sam-mendis/4YP/README.md

# 4YP
My fourth year project repository, looking at designing a lifetime testing container for a 30mm*30mm organic solar cell sample.
Needs to fit inside a glovebox of 150mm diameter
