sam-mendis/4YP/Report/Michaelmas report/Michaelmas report plan.docx

Michaelmas report plan:

1. Introduction:
  a. Define project and aims
  b. Discuss why the project is needed
  c. Review literature to enhance argument for the project
2. What I have done so far:
  a. Talk about research
  b. Learning and creating models on openscad: show 3d model of design
  c. Discuss the research on materials
  d. Discuss the processes what methods of manufacturing
3. Where I will go next:
  a. Initial next steps – coming weeks
  b. Overall next steps, how I am going to accomplish the aims listed
  c. Gant chart showing my progress
4. Conclusion
  a. Show that project is integral
  b. Reiterate how it is on track.

Process generally completed dimensions entire
