sam-mendis/4YP/Report/Samuel Mendis Interim Report.pdf

## Open Science Hardware Setup for investigating the Stability of Organic

## Solar Cells - Interim Report

Samuel Mendis

Department of Engineering Science, University of Oxford

Department of Physics, University of Oxford

23rd November 2020

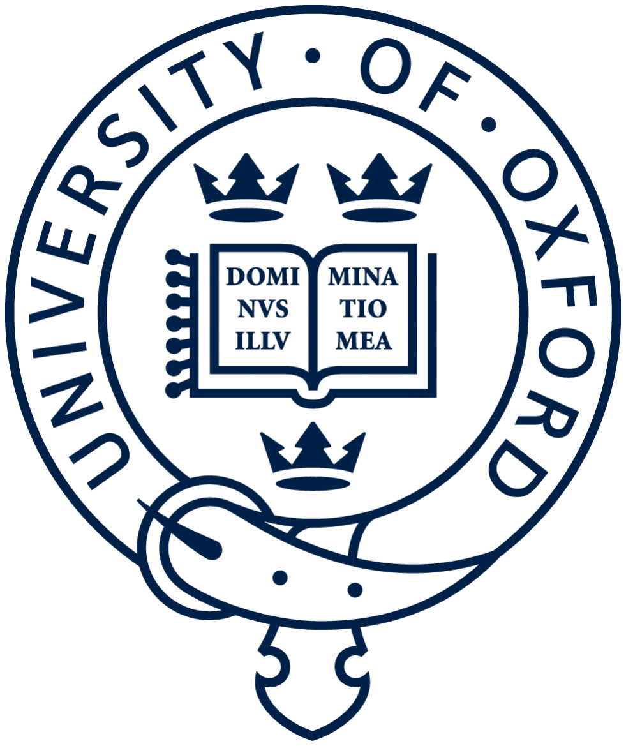
[picture p4: figure]

## 1 Introduction

Solar cells are becoming increasingly prevalent in the fight against climate change[1, p. 34], leading demand

to increase worldwide. This project aims to contribute to the development of the next generation of solar

cells to be manufactured out of carbon-based materials (rather than the current industry standard of

silicon). Currently, controlled lifetime testing of organic solar cells is difficult due to the multitude of

failure mechanisms. These are caused by chemical degradation via oxygen and water[2, p. 689]. To

combat this problem, this project will design, manufacture and test a well controlled lifetime solar testing

container. This project is being run in conjunction with the Advanced Functional Materials and Devices

group (AFMD) in the department of Physics, headed by Professor Moritz Riede. Therefore I am, and

will be collaborating closely with the members of AFMD to ensure the device meets the specification they

require. A key tenet of the project is ensuring the accessibility of the research through the use of open

hardware in order for the potential acceleration of the development of organic solar cells.

## 2 Aims and Objectives

The aim of the container is to simulate a lifetime (for example: 20 years) of real world degradation in a

reasonable timeframe. Reasonable means that ideally the testing container should be able to test the solar

cell in a short cycle test (15 minutes) or a long multiple cycle test (up to 3 months). To ensure accurate

testing of the cells, the container needs to be airtight. This is to prevent any uncontrolled variables from

entering the testing container and causing degradation of the cell. Furthermore, the container should have

gas inlets and outlets so that the conditions that the solar cell is tested under can be varied in a controlled

manner. This will be in conjunction with a temperature controller capable of varying the temperature

of the solar cell up to 120°C. These objectives were guided by the paper Consensus stability testing

protocols for organic photovoltaic materials and devices [3, p. 1255-1261] which cites multiple different

testing criteria for an organic solar cell - in the absence of a tailored ISO standard. Additional aims

that would enhance the scope of the project is a graphical user interface (GUI) developed to control the

conditions within the testing container. To ensure the project is completed, not all the components will

be manufactured from scratch, some will be purchased while others are provided by the AFMD research

group and existing open science hardware/software efforts. Some of the components include: the push-fit

valves, a safety relief valve, o-rings, a mass flow controller and an illumination source.

## 3 Progress

At this stage in the year, the container is past the design stage and is onto manufacturing, with the

outer shell being manufactured within the Engineering Science Workshop. A full design was completed

using the open source software OpenSCAD. Using inspiration from Karl-Augustin Zaininger (a Physics

researcher who has developed a similar type of device, without the functionality) a CAD model of the

testing container was built and is shown in Figure 1.The outer shell (coloured in green) is the component

currently bring manufactured. The red circular parts will be 3D printed using acrylic and will be used to

hold metal pins to connect a controller on the outside to the instrumentation within. The three important

factors that the container had to accommodate were: the substrate (shown in black in Figure 1), any

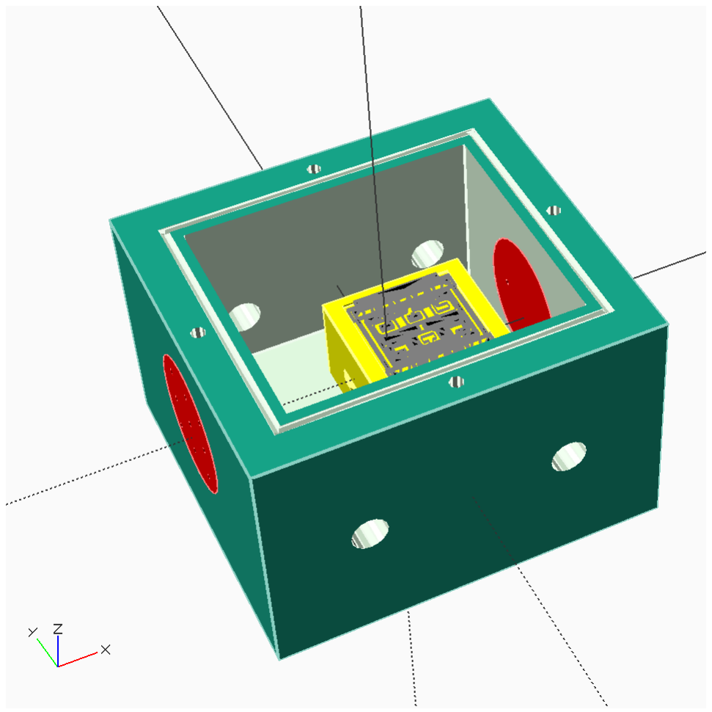
[picture p5: figure]

(a) Plan View of Model | (b) Isometric View of Model

Figure 1: Showing plan and isometric view of the full OpenSCAD model

electronic devices (e.g. a temperature controller) and gas inlet ports. The substrate used carries 6 solar

cells with dimensions of 30 mm x 30 mm and a thickness of 1.1 mm. The substrate design in Figure 1

was provided to me by Dr Grey Christophoro - Physics researcher [4]. In order to carry the substrate in

the testing container, a substrate holder (coloured yellow in Figure 1) was designed to fit within the outer

shell of the box. The modular design is deliberate to allow the user to modify which cells and layouts are

being tested, without the redesign of the entire container, just the substrate holder; thereby saving those

who may need to use it in the future valuable time and money.

## 4 Future Work

During the manufacturing of the box, there is an opportunity to start on simulations of the heat and

mass flow within the container. These simulations will be conducted using SOLIDWORKS flow and

heat simulations features to provide a more accurate picture of the environmental variation around the

substrate. These simulations will allow the user to control the environment with a better understanding,

hence creating more consistent ageing conditions. Once the outer shell has been manufactured, following

key steps are to pressure test the vessel, implement the control electronics, calibrate the temperature

and environmental sensors as well as installing the container in front of a lamp. Once the calibration is

complete the container will be assessed in known control environments to check whether the solar cells

output as predicted. The Gantt chart (shown in the Appendix) shows the full outline of the future plans

including contingency time at the end of Hilary term.

## References

[1] International Energy Agency. World Energy Outlook 2020. OECD Publishing, 2020. URL https: //www.oecd-ilibrary.org/content/publication/557a761b-en.
[2] Mikkel Jørgensen, Kion Norrman, and Frederik C Krebs. Stability/degradation of polymer solar cells. Solar energy materials and solar cells, 92(7):686–714, 2008. ISSN 0927-0248.
[3] Matthew O Reese, Suren A Gevorgyan, Mikkel Jørgensen, Eva Bundgaard, Sarah R Kurtz, David S Ginley, Dana C Olson, Matthew T Lloyd, Pasquale Morvillo, and Eugene A Katz. Consensus stability testing protocols for organic photovoltaic materials and devices. Solar Energy Materials and Solar Cells, 95(5):1253–1267, 2011. ISSN 0927-0248.
[4] AFMD Layout Github Repository, Accessed 30/09/2020. URL https://github.com/AFMD/layouts.

# Appendices

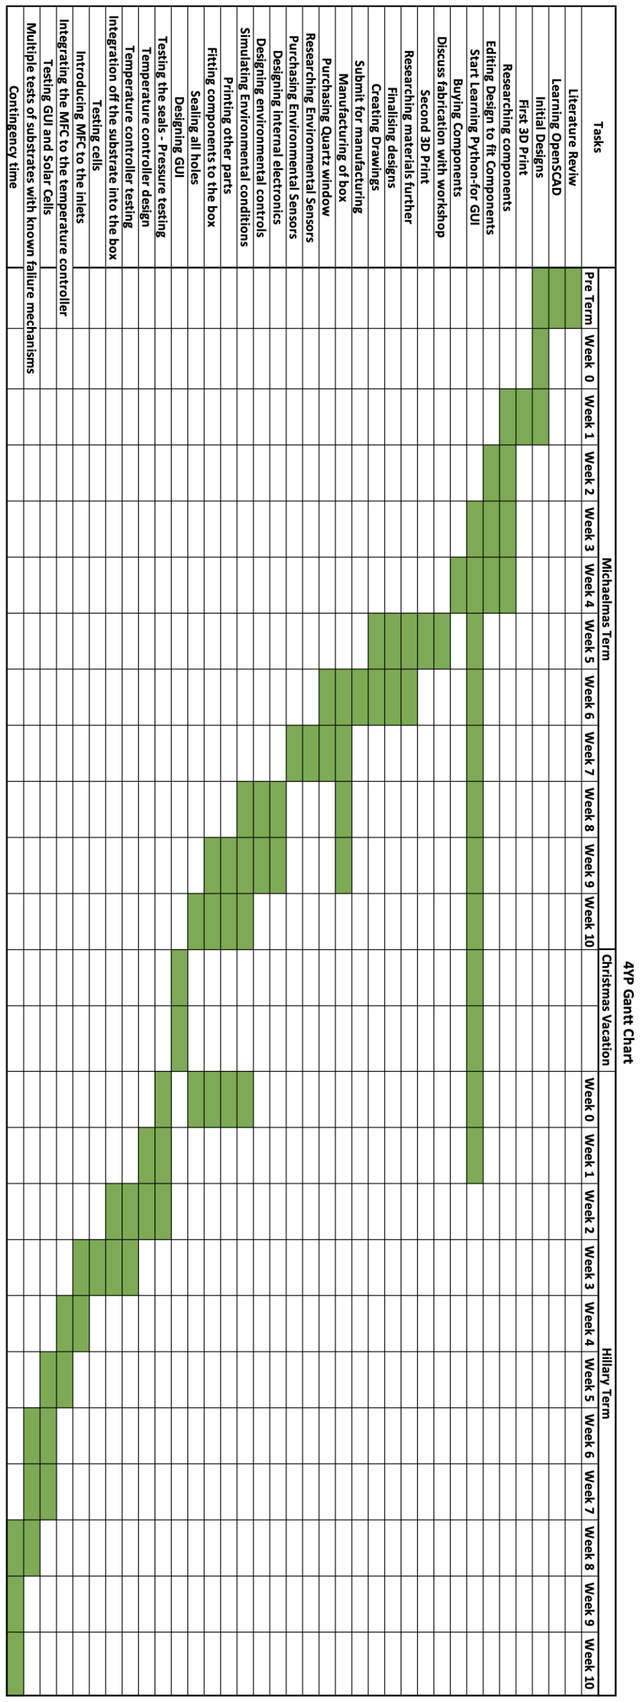
[picture p6: figure]
