sam-mendis/4YP/Report/First attempt /Images/Appendix/Appendix_1.png

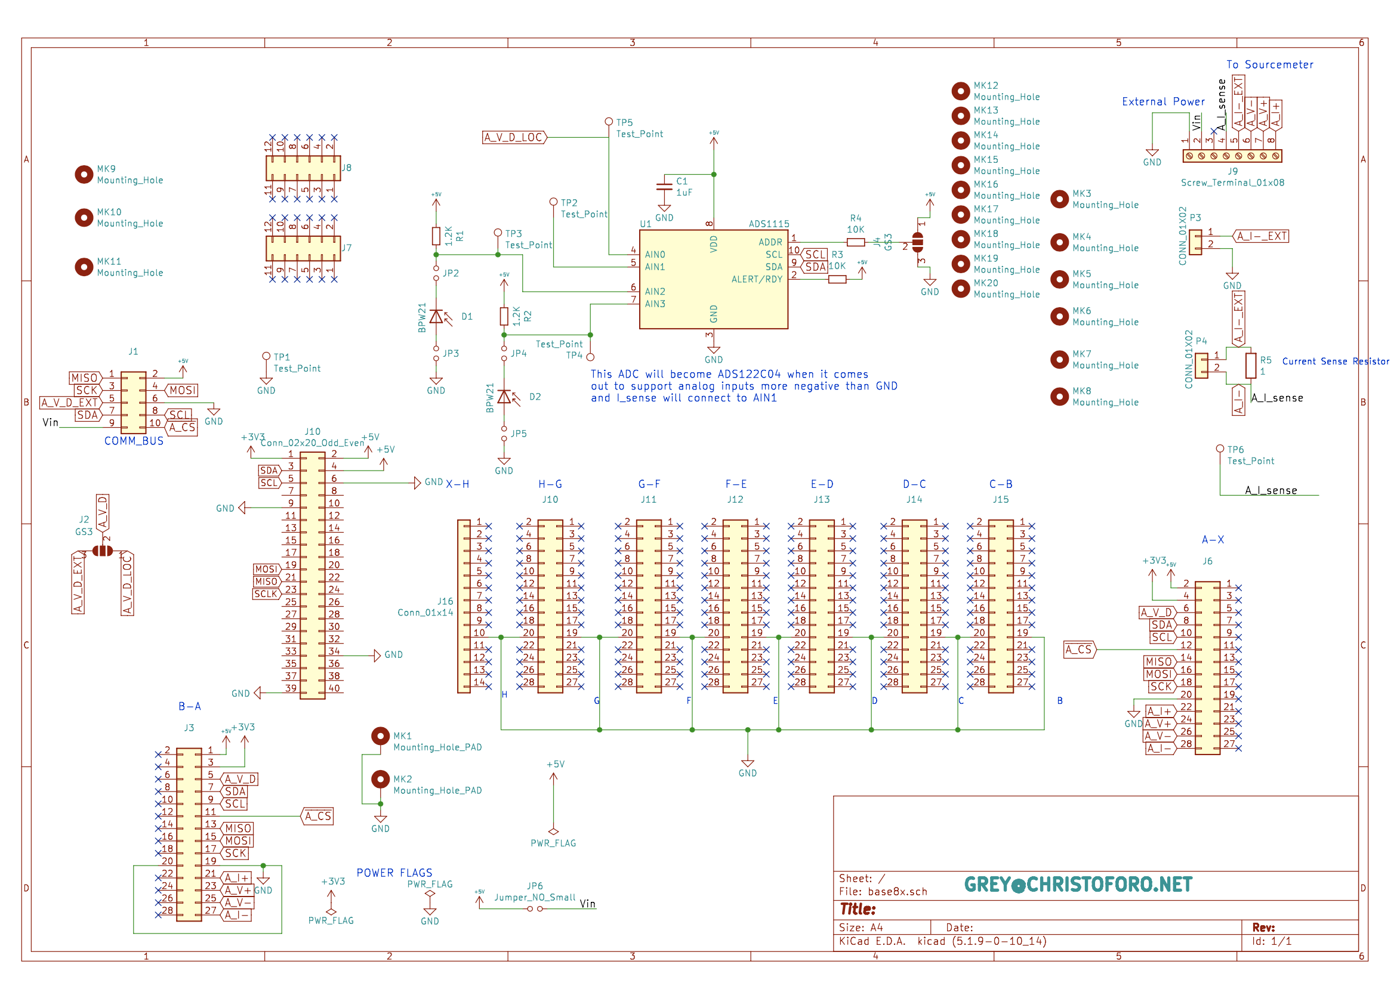
Report/First attempt /Images/Appendix/Appendix_1.png
