sam-mendis/4YP/Report/First attempt /Images/Appendix/Appendix_2.png

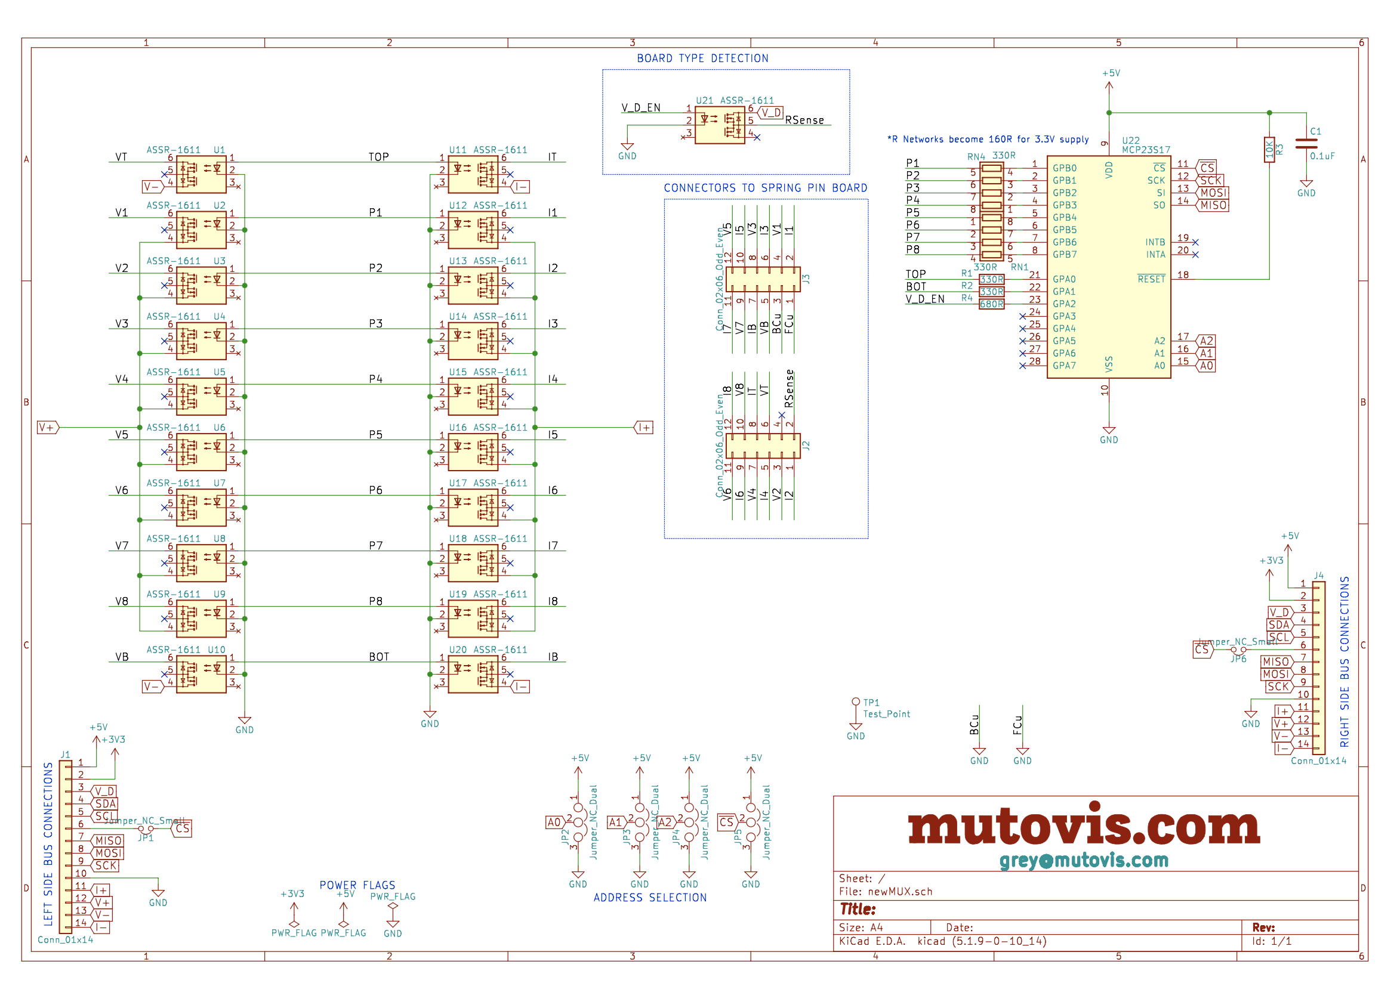
Report/First attempt /Images/Appendix/Appendix_2.png
