sam-mendis/4YP/Report/First attempt /Images/Appendix/Appendix_3.png

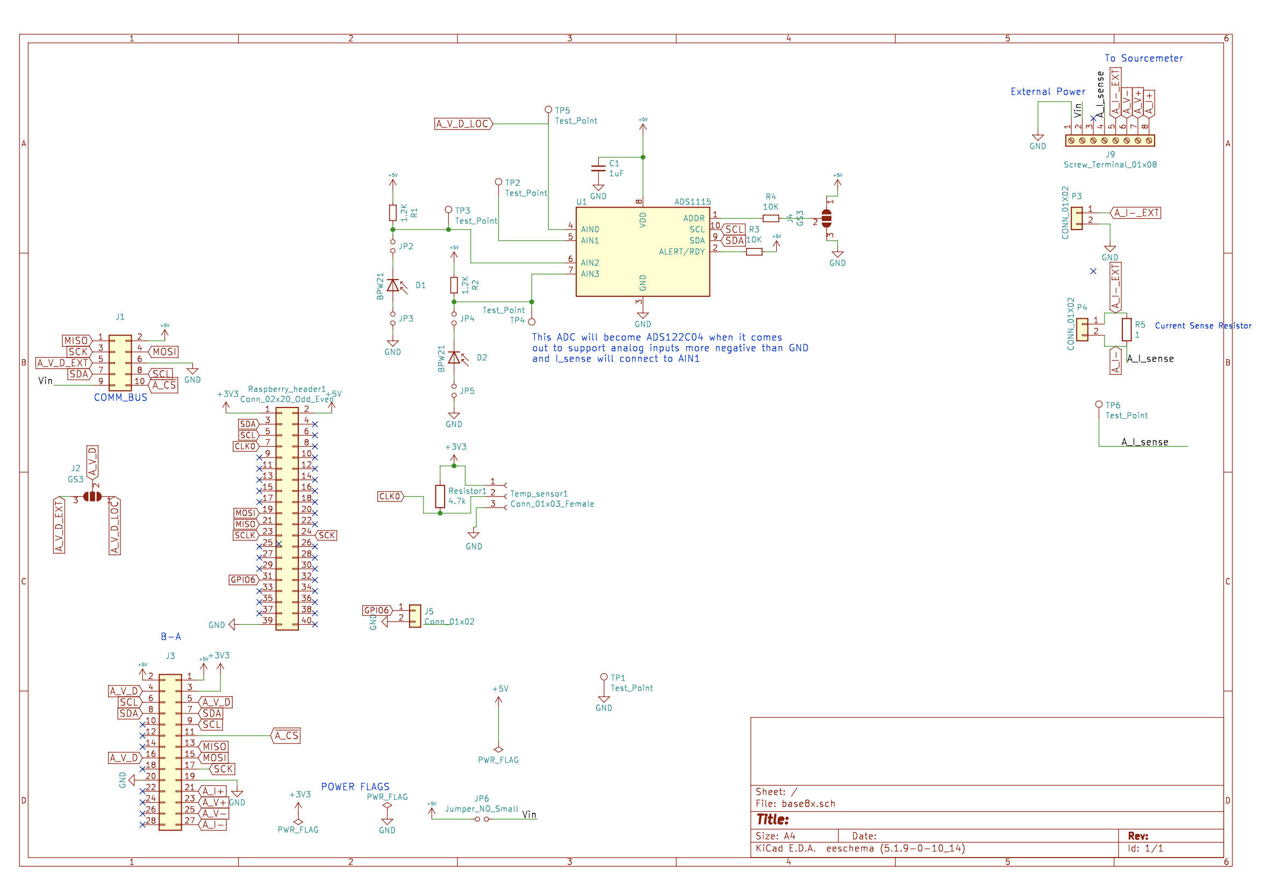
Report/First attempt /Images/Appendix/Appendix_3.png
