sam-mendis/4YP/Report/First attempt /Images/Appendix/Appendix_4.png

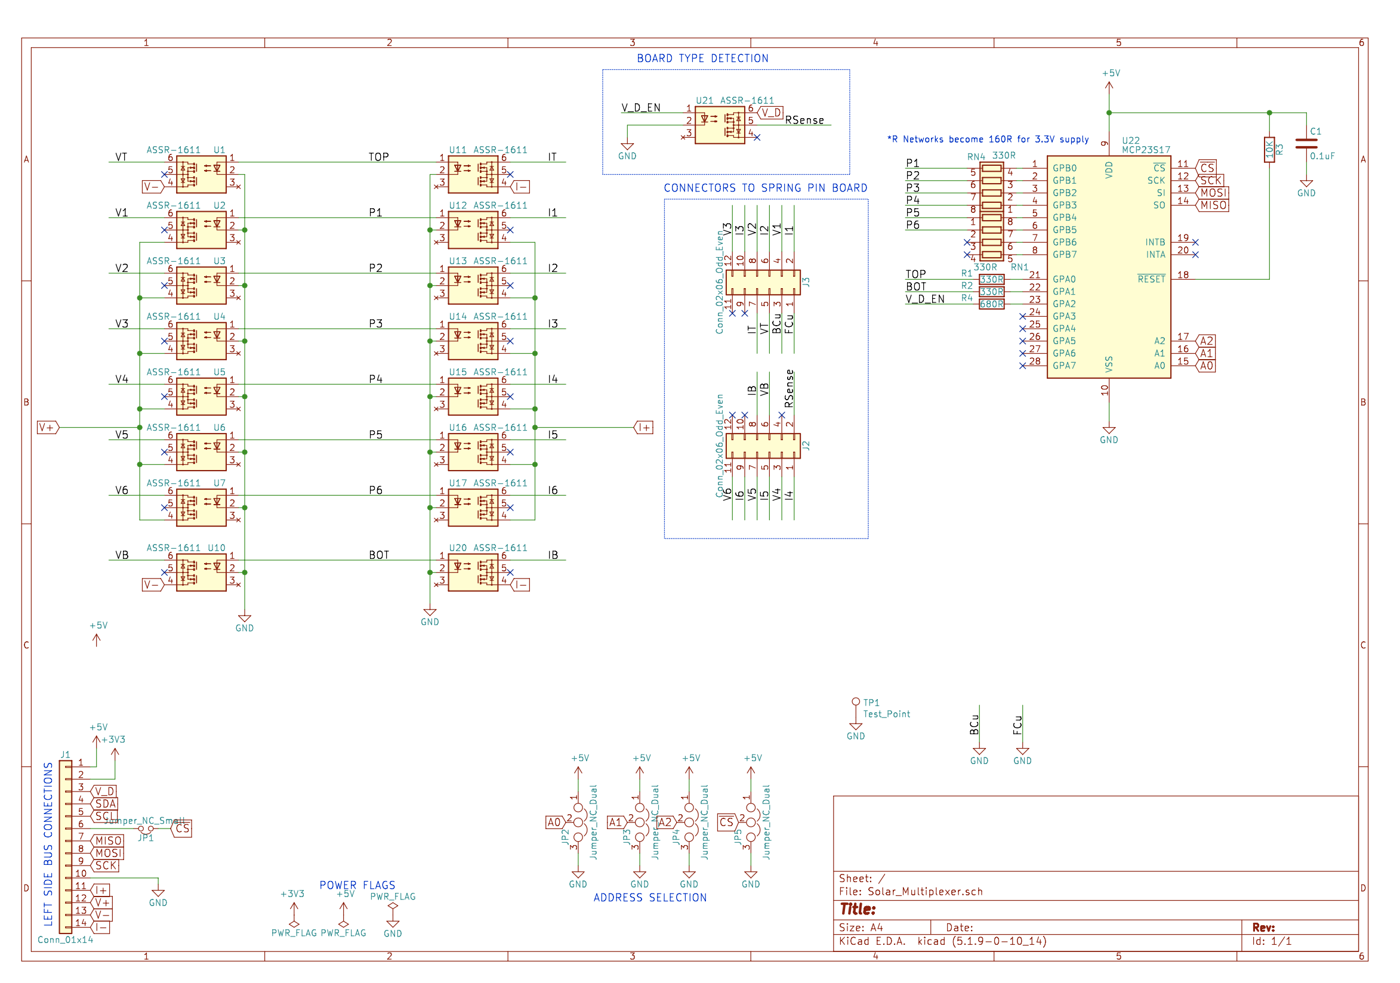
Report/First attempt /Images/Appendix/Appendix_4.png
