sam-mendis/4YP/Report/First attempt /Images/Appendix/Appendix_5.png

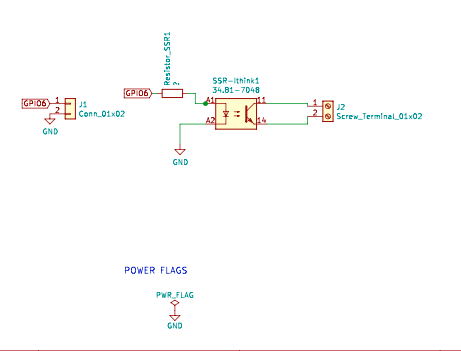
Report/First attempt /Images/Appendix/Appendix_5.png
