sam-mendis/4YP/Report/First attempt /Images/Appendix/Appendix_6.png

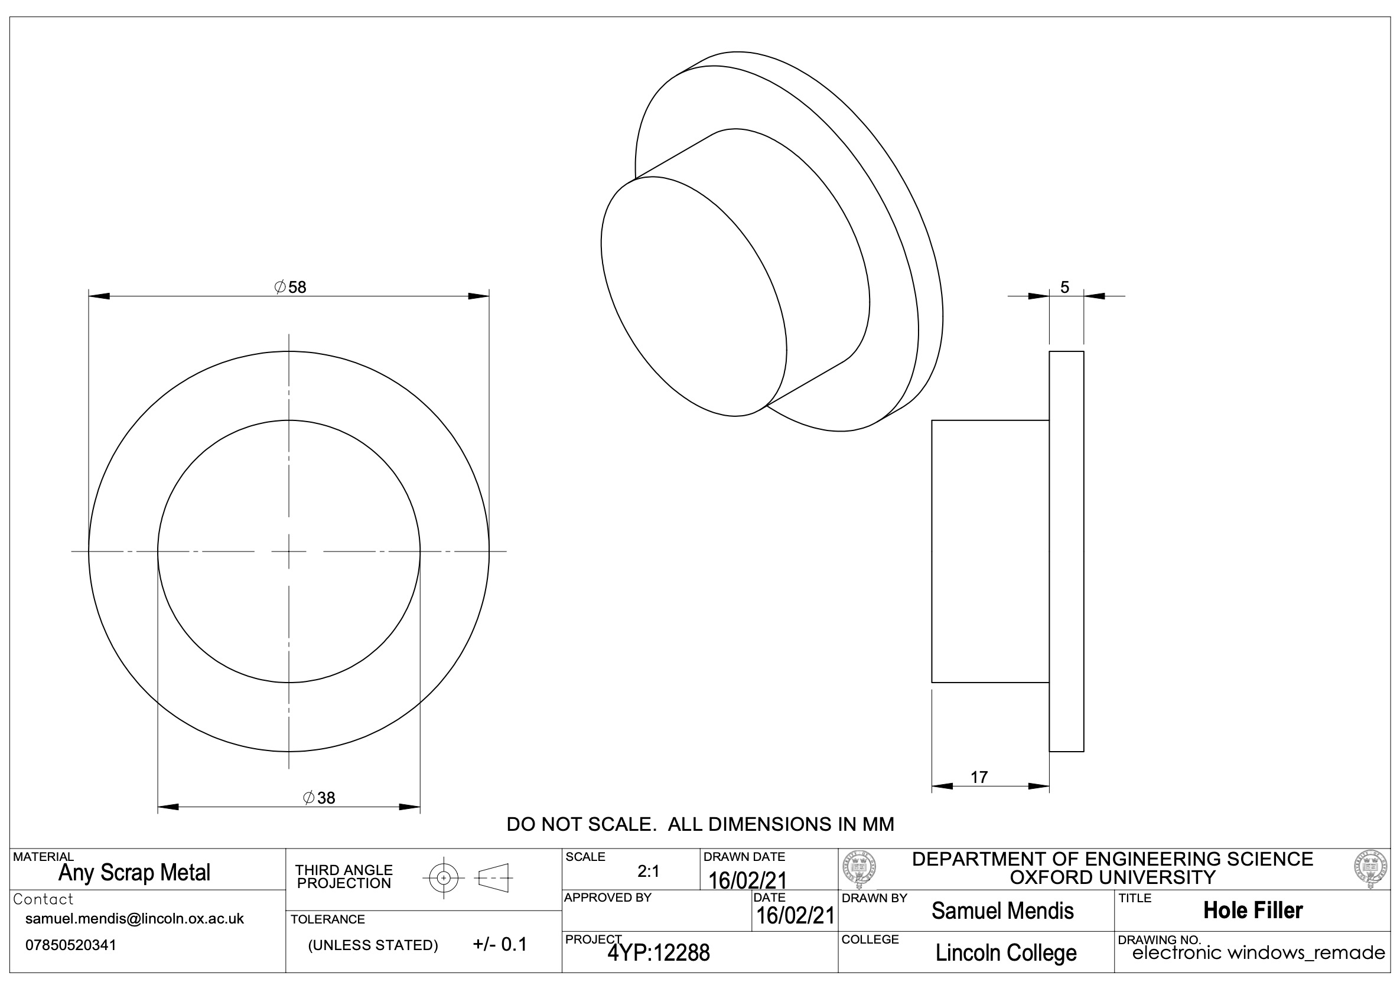
Report/First attempt /Images/Appendix/Appendix_6.png
