sam-mendis/4YP/Report/First attempt /Images/Appendix/Drawing1.png

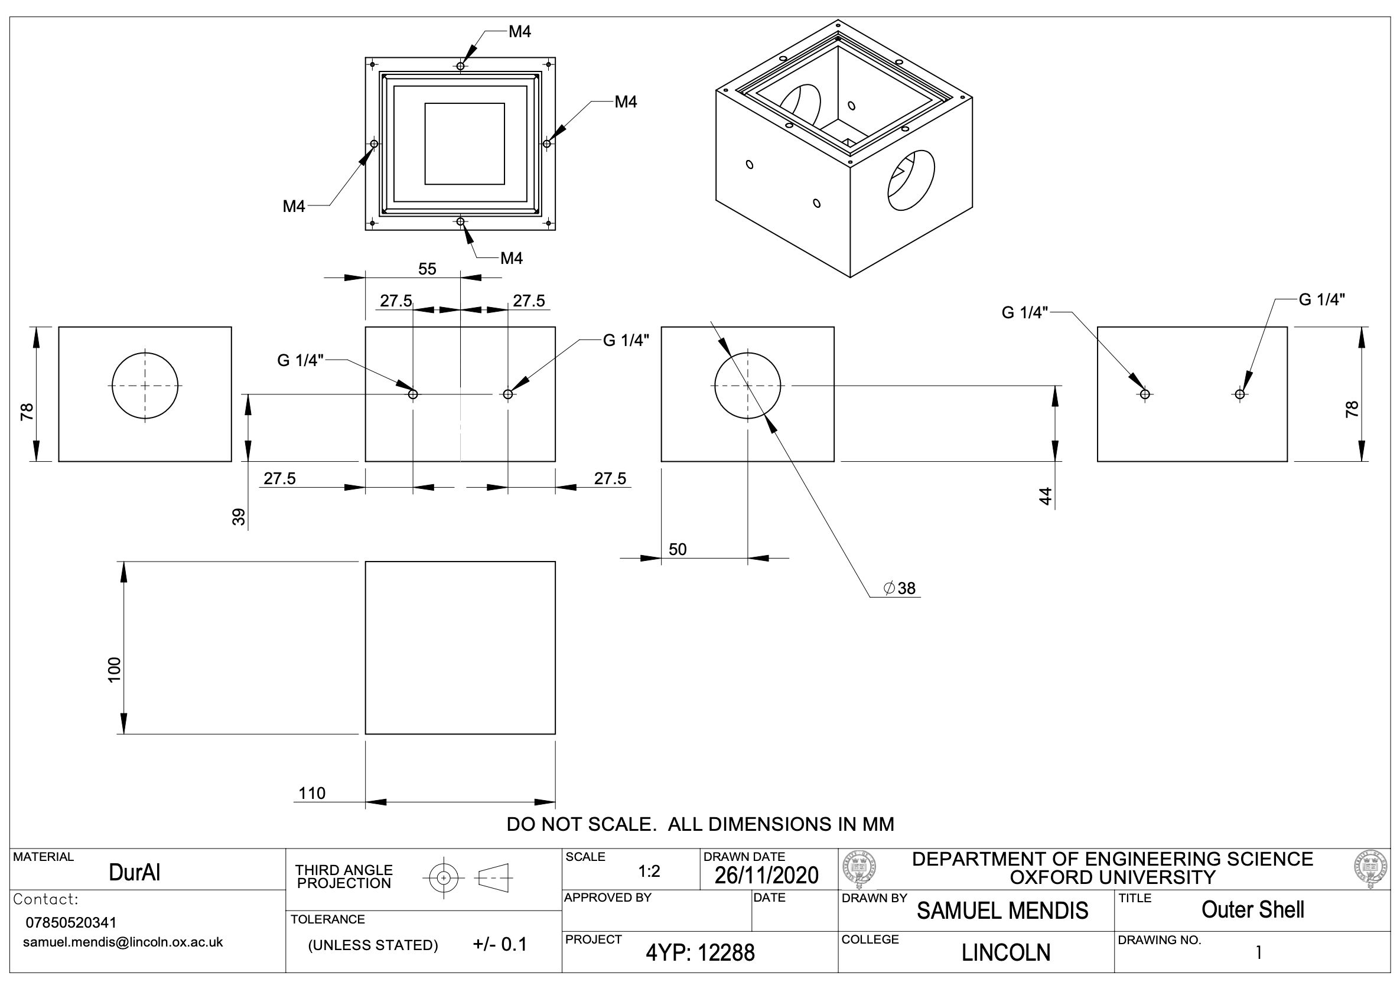
Report/First attempt /Images/Appendix/Drawing1.png
