sam-mendis/4YP/Report/First attempt /Images/Appendix/Drawing2.png

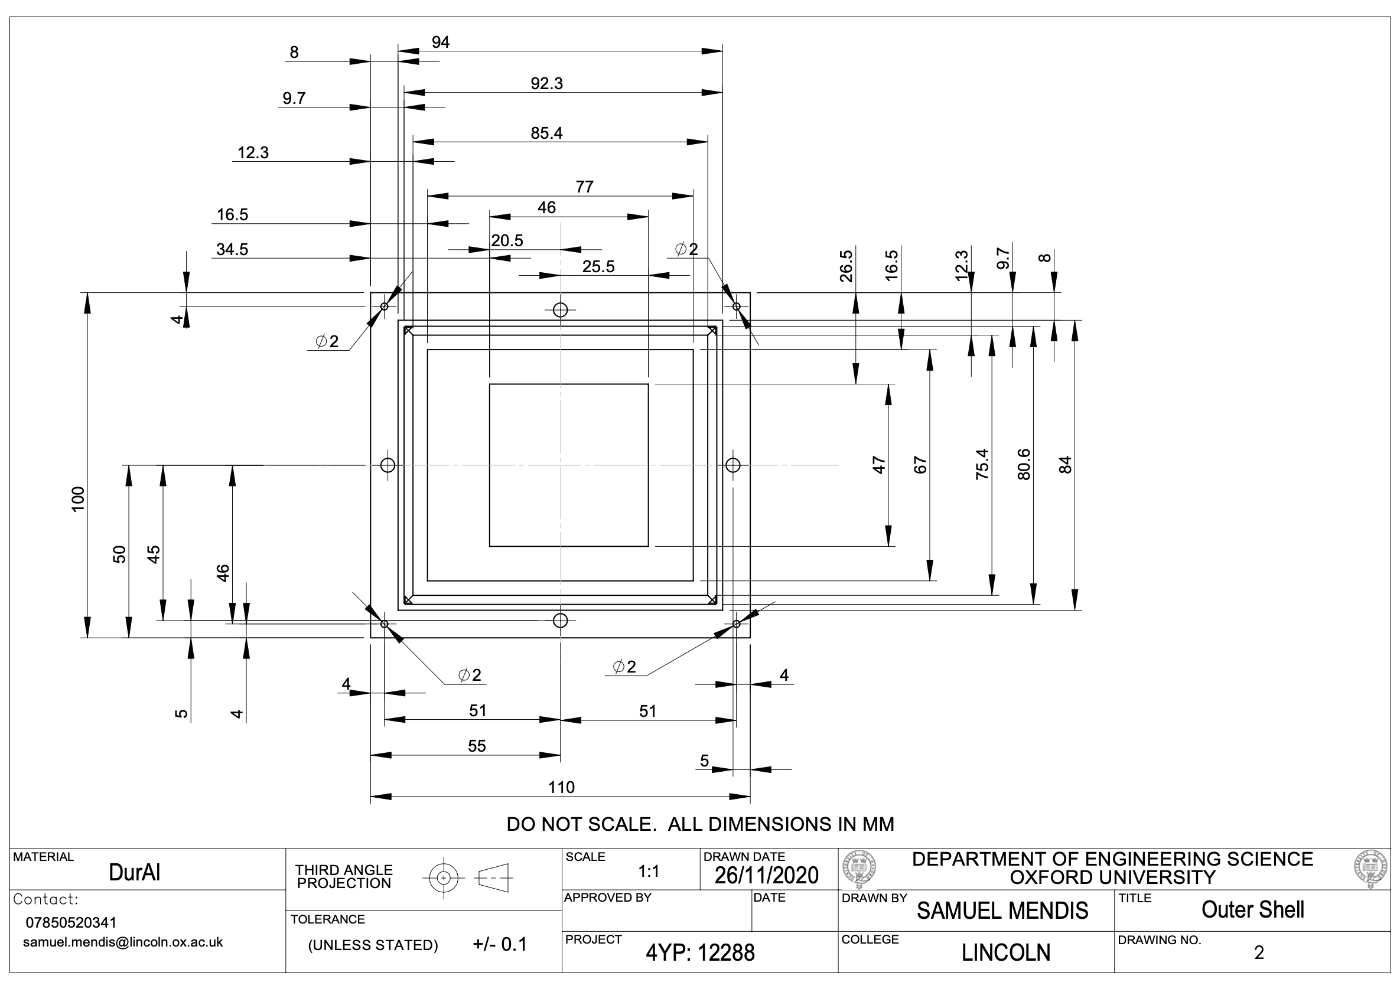
Report/First attempt /Images/Appendix/Drawing2.png
