sam-mendis/4YP/Report/First attempt /Images/Appendix/Drawing3.png

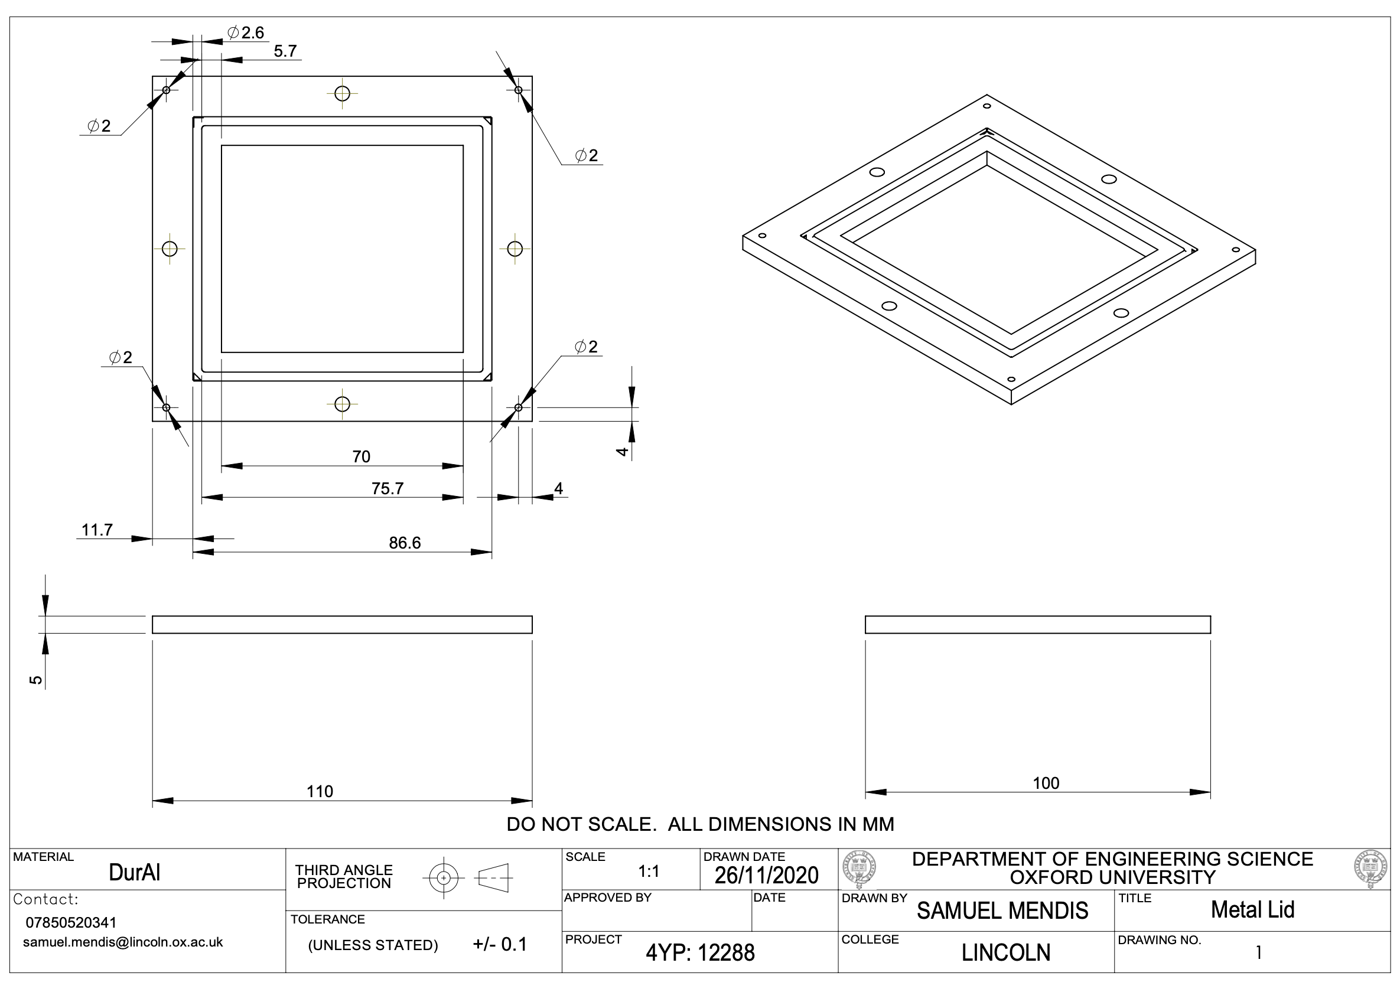
Report/First attempt /Images/Appendix/Drawing3.png
