sam-mendis/4YP/Report/First attempt /Images/Appendix/Gantt.png

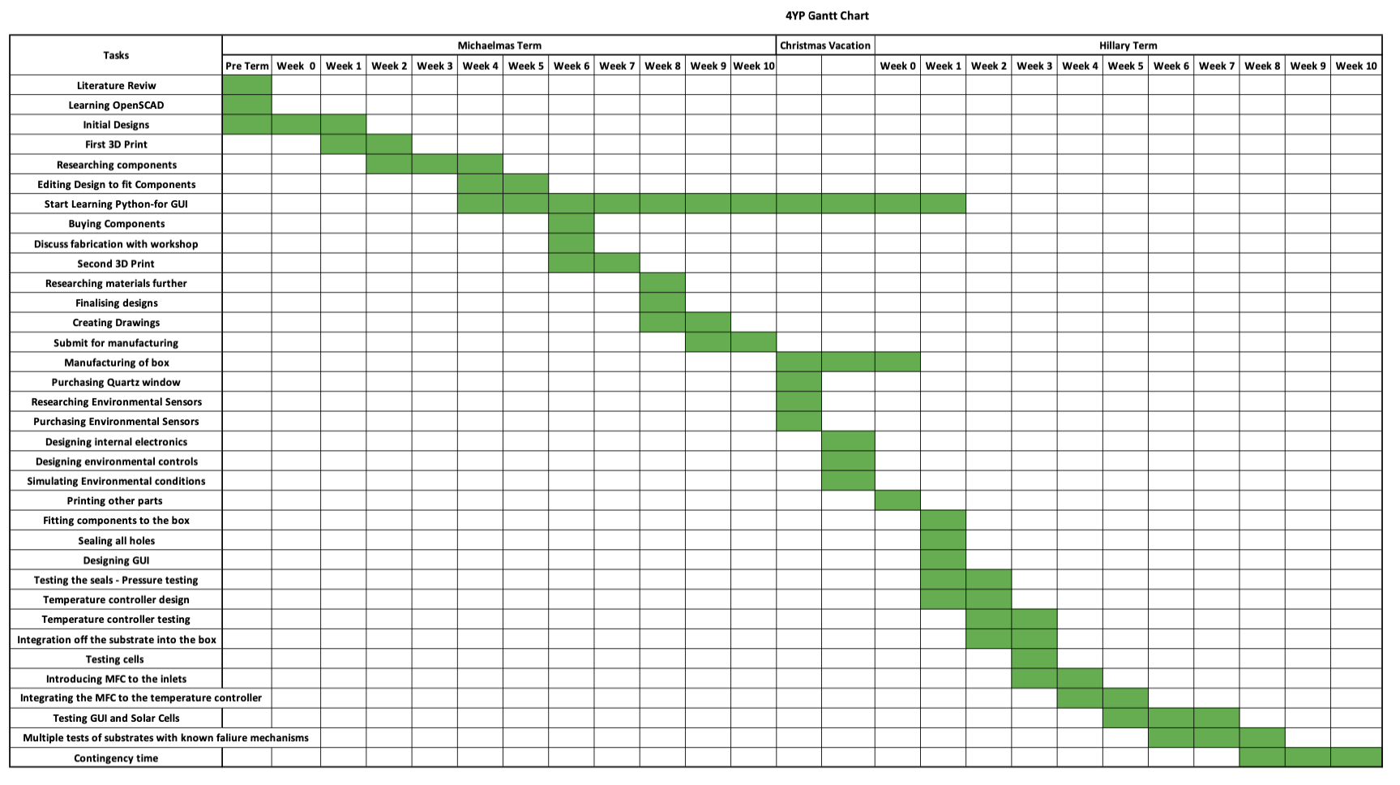
Report/First attempt /Images/Appendix/Gantt.png
