sam-mendis/4YP/Report/First attempt /Images/Appendix/Gantt_covid.png

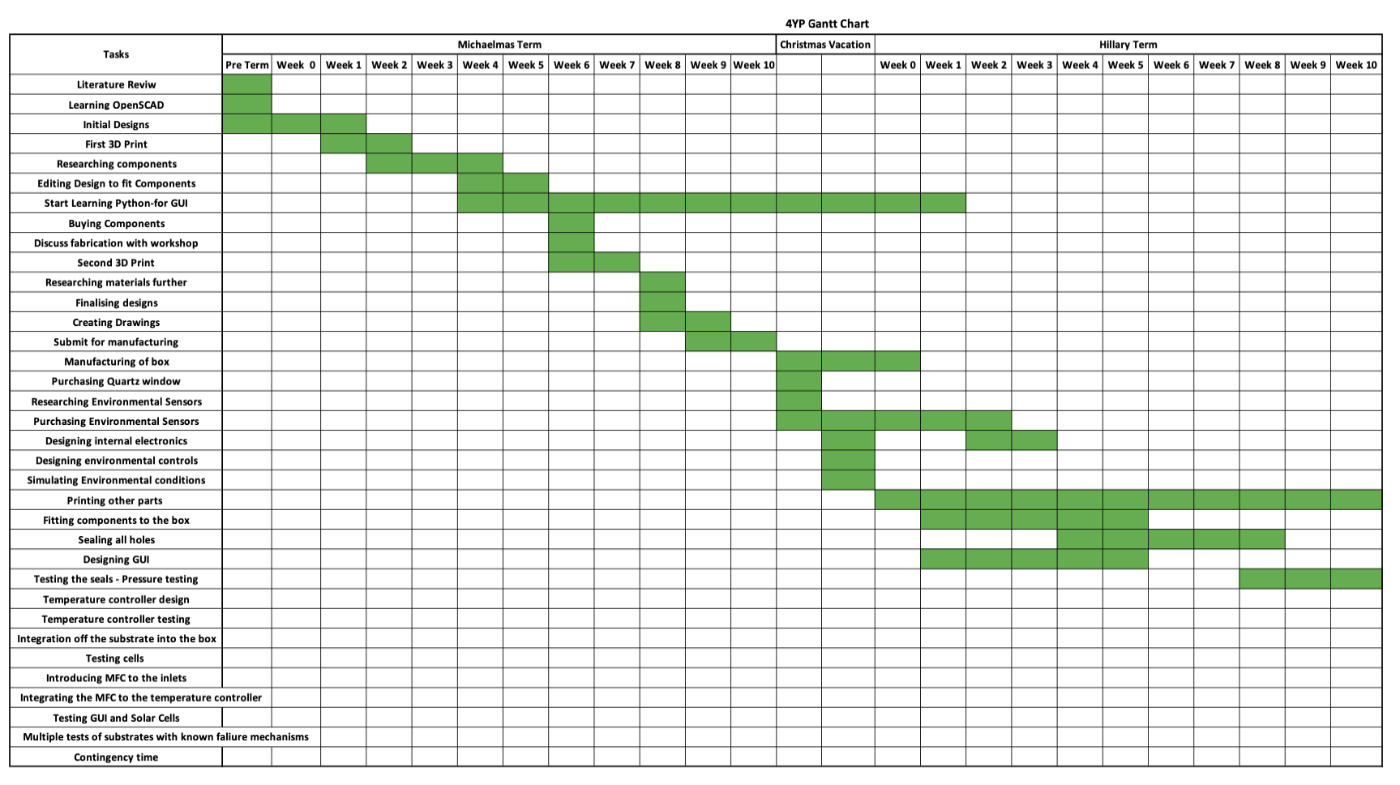
Report/First attempt /Images/Appendix/Gantt_covid.png
