sam-mendis/4YP/Report/First attempt /Images/Conclusion/finish.png

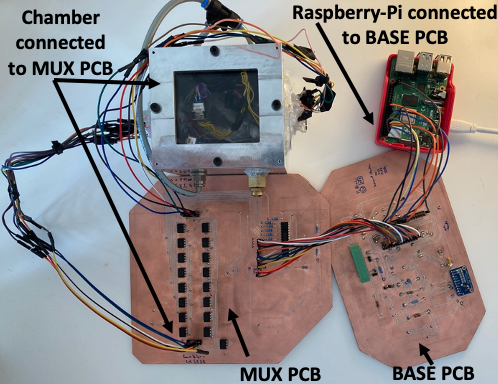
Report/First attempt /Images/Conclusion/finish.png
