sam-mendis/4YP/Report/First attempt /Images/Conclusion/modified.png

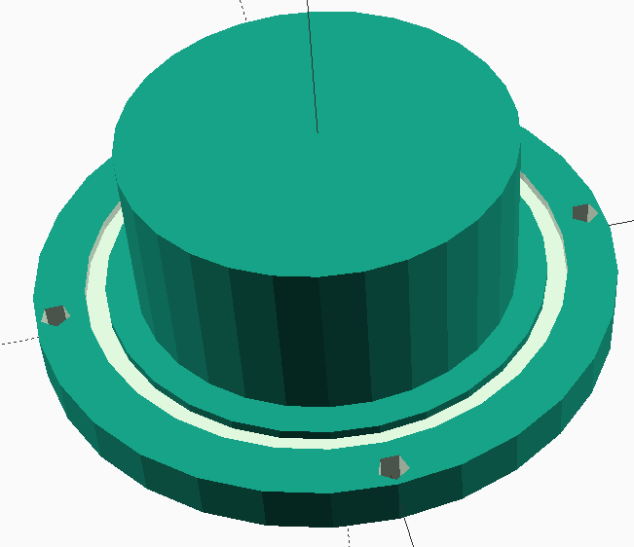
Report/First attempt /Images/Conclusion/modified.png
