sam-mendis/4YP/Report/First attempt /Images/Design_chapter/Design_5.png

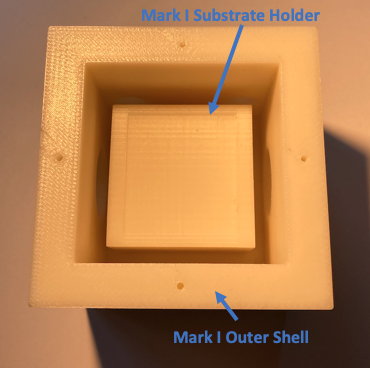
Report/First attempt /Images/Design_chapter/Design_5.png
