sam-mendis/4YP/Report/First attempt /Images/Design_chapter/GUI.png

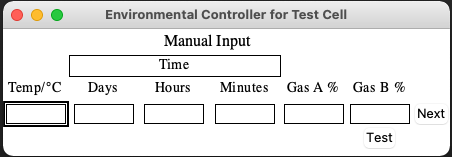
Report/First attempt /Images/Design_chapter/GUI.png
