sam-mendis/4YP/Report/First attempt /Images/Design_chapter/metal_lid_CAD.png

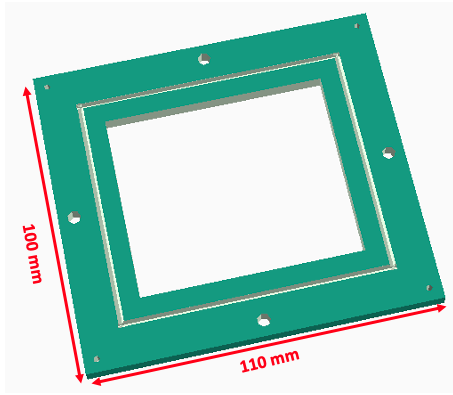
Report/First attempt /Images/Design_chapter/metal_lid_CAD.png
