sam-mendis/4YP/Report/First attempt /Images/Design_chapter/MUX_3D_2.png

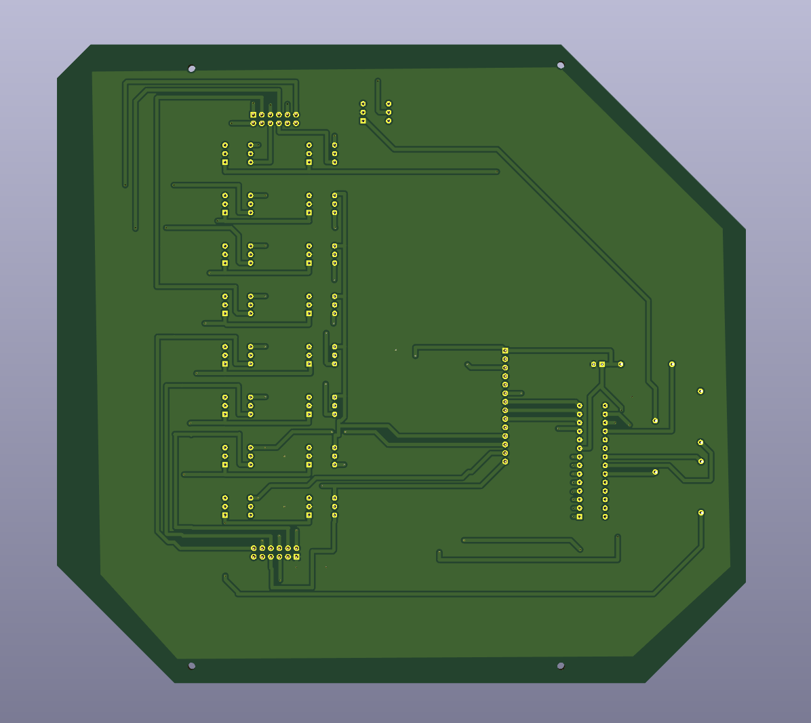
Report/First attempt /Images/Design_chapter/MUX_3D_2.png
