sam-mendis/4YP/Report/First attempt /Images/Intro/HT3_Fig1.png

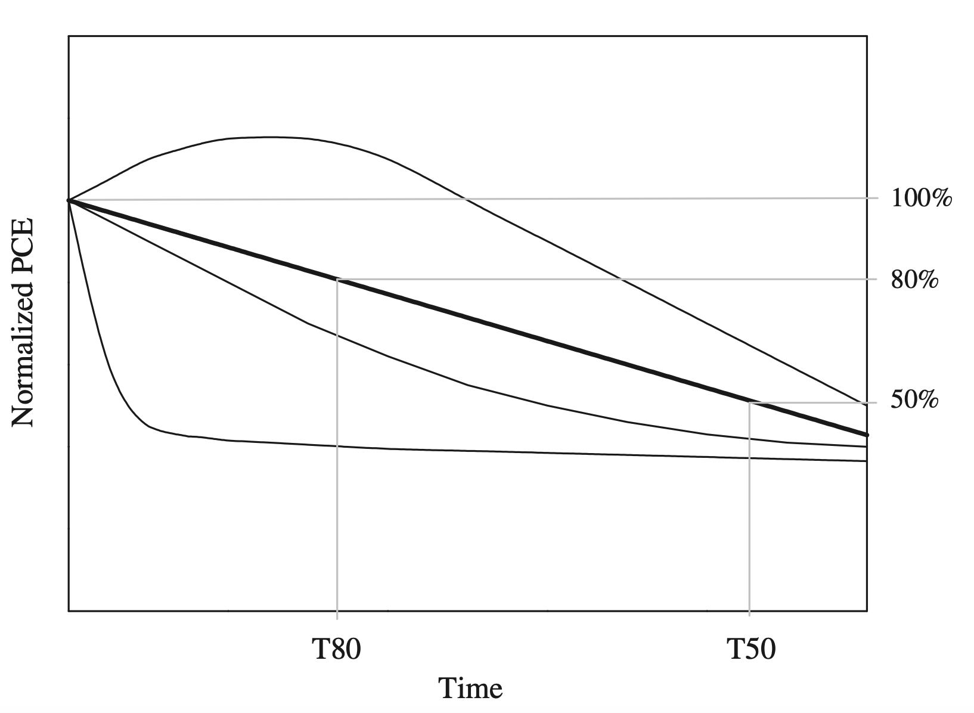
Report/First attempt /Images/Intro/HT3_Fig1.png
