sam-mendis/4YP/Report/First attempt /Images/Intro/HT3_Fig2.png

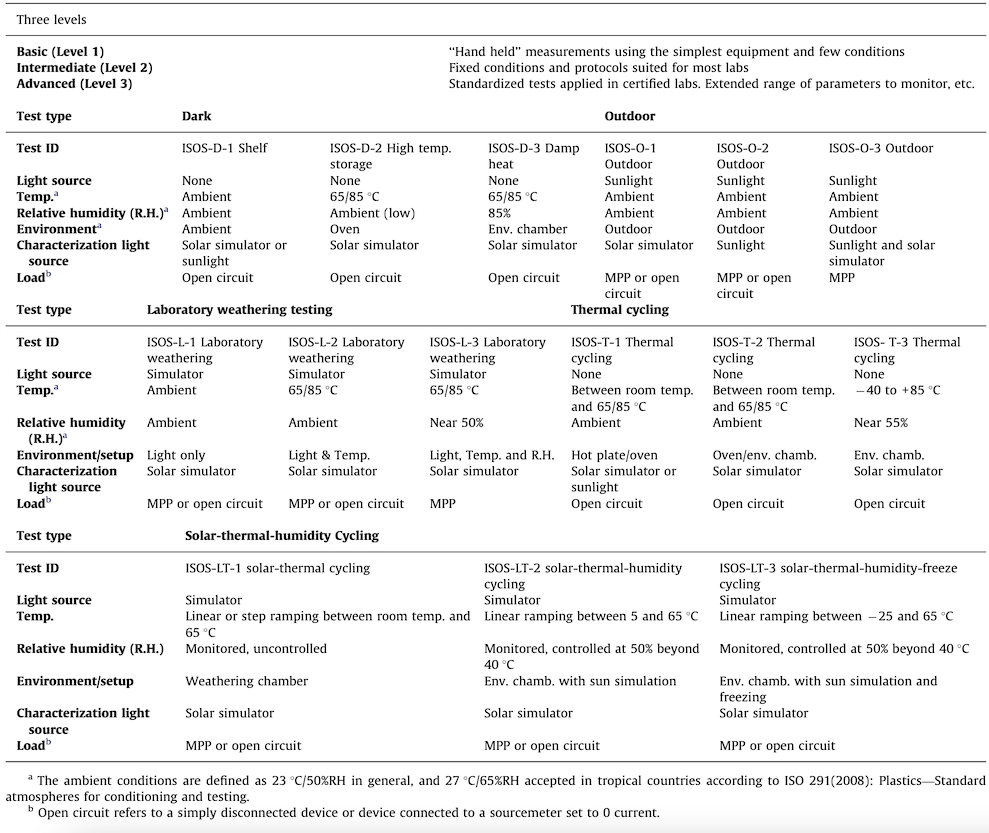
Report/First attempt /Images/Intro/HT3_Fig2.png
