sam-mendis/4YP/Report/First attempt /Images/Intro/HT10_Fig1.png

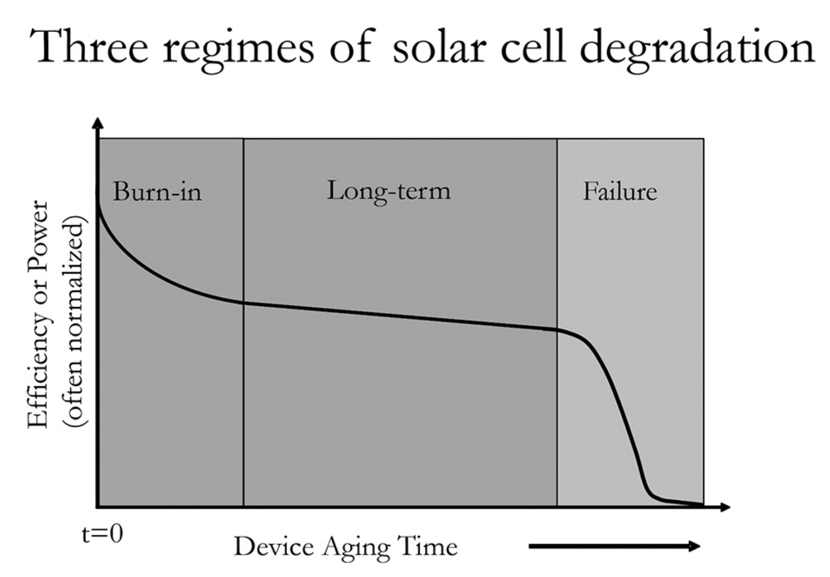
Report/First attempt /Images/Intro/HT10_Fig1.png
