sam-mendis/4YP/Report/First attempt /Images/Intro/IV.png

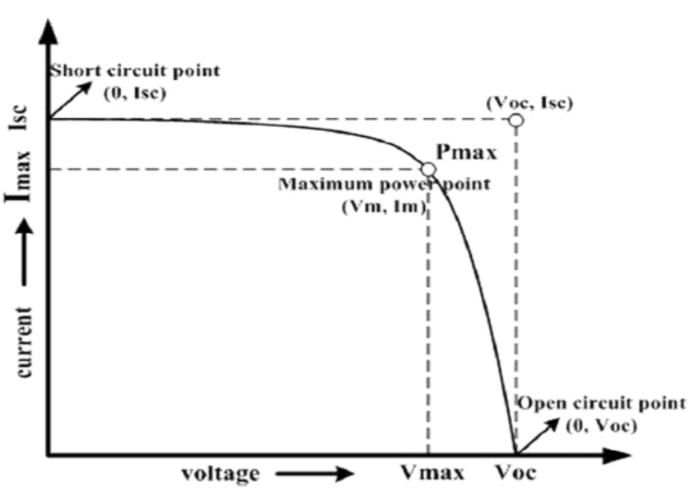
Report/First attempt /Images/Intro/IV.png
