sam-mendis/4YP/Report/First attempt /Images/Intro/N2_deg.png

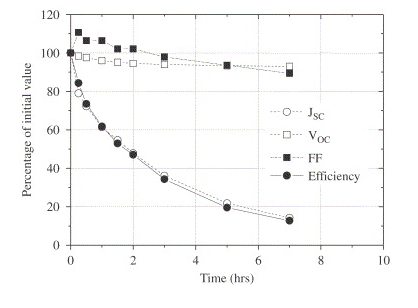
Report/First attempt /Images/Intro/N2_deg.png
