sam-mendis/4YP/Report/First attempt /Images/Intro/O2_deg.png

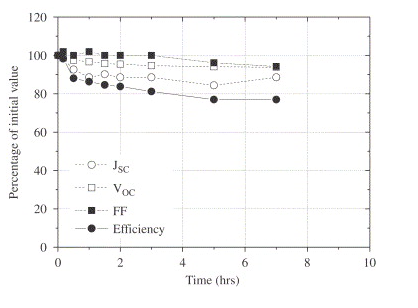
Report/First attempt /Images/Intro/O2_deg.png
