sam-mendis/4YP/Report/Michaelmas report/figures/fig2.png

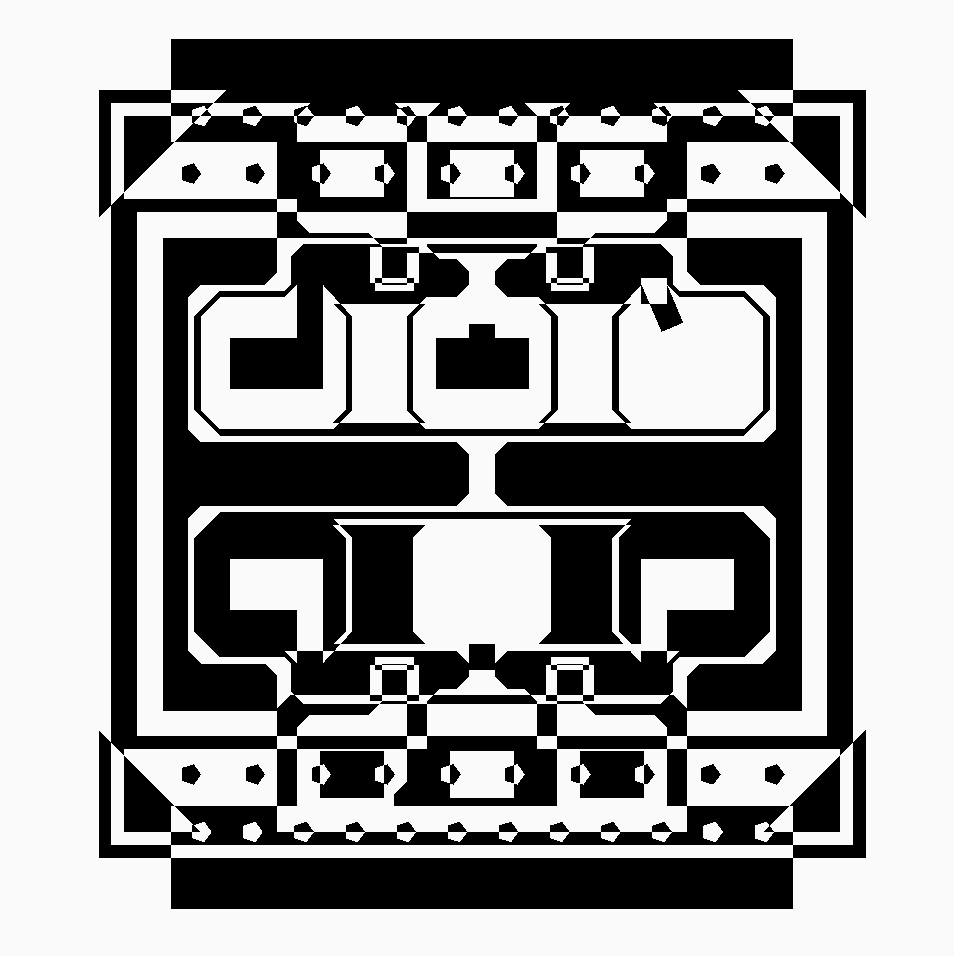
Report/Michaelmas report/figures/fig2.png
