sam-mendis/4YP/Report/Michaelmas report/figures/Screenshot 2020-11-16 at 15.58.15.png

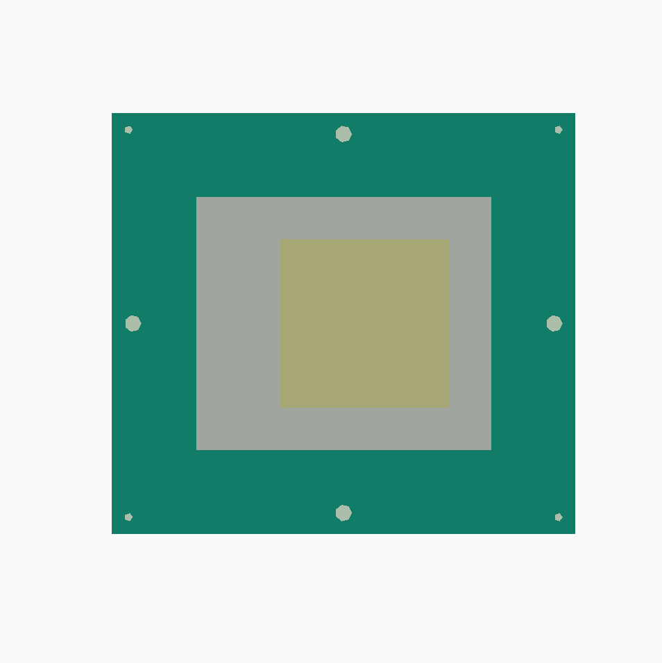
Report/Michaelmas report/figures/Screenshot 2020-11-16 at 15.58.15.png
