sam-mendis/4YP/Report/Michaelmas report/figures/title_fig.png

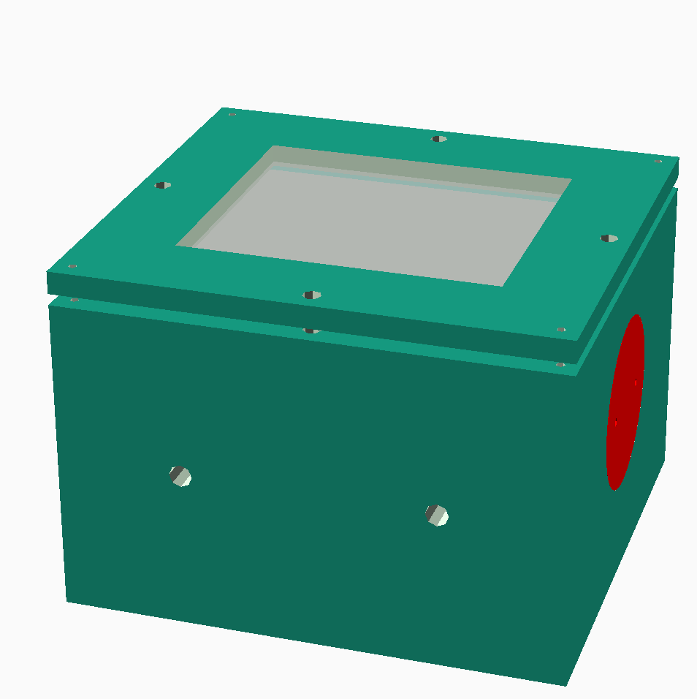
Report/Michaelmas report/figures/title_fig.png
