sam-mendis/4YP/Report/Michaelmas report/Images/Iso view Openscadmodel.png

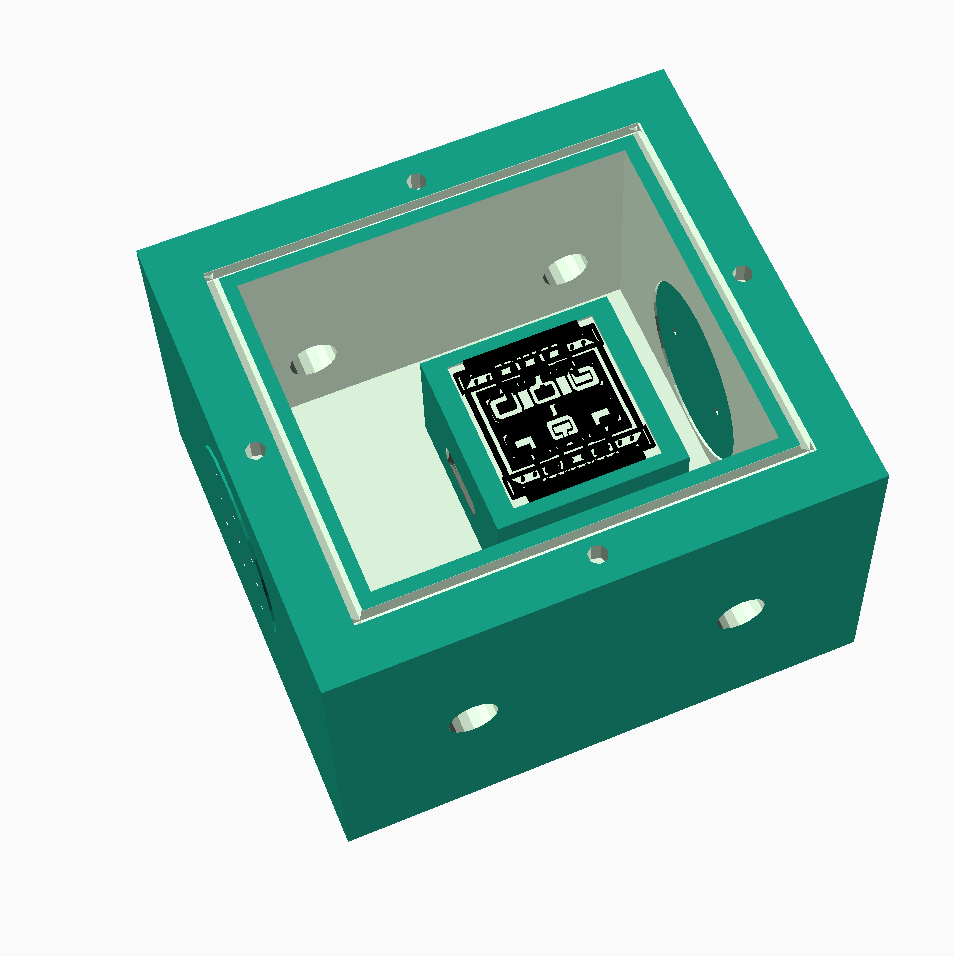
Report/Michaelmas report/Images/Iso view Openscadmodel.png
