sam-mendis/4YP/Report/Michaelmas report/Images/Plan View Openscadmodel.png

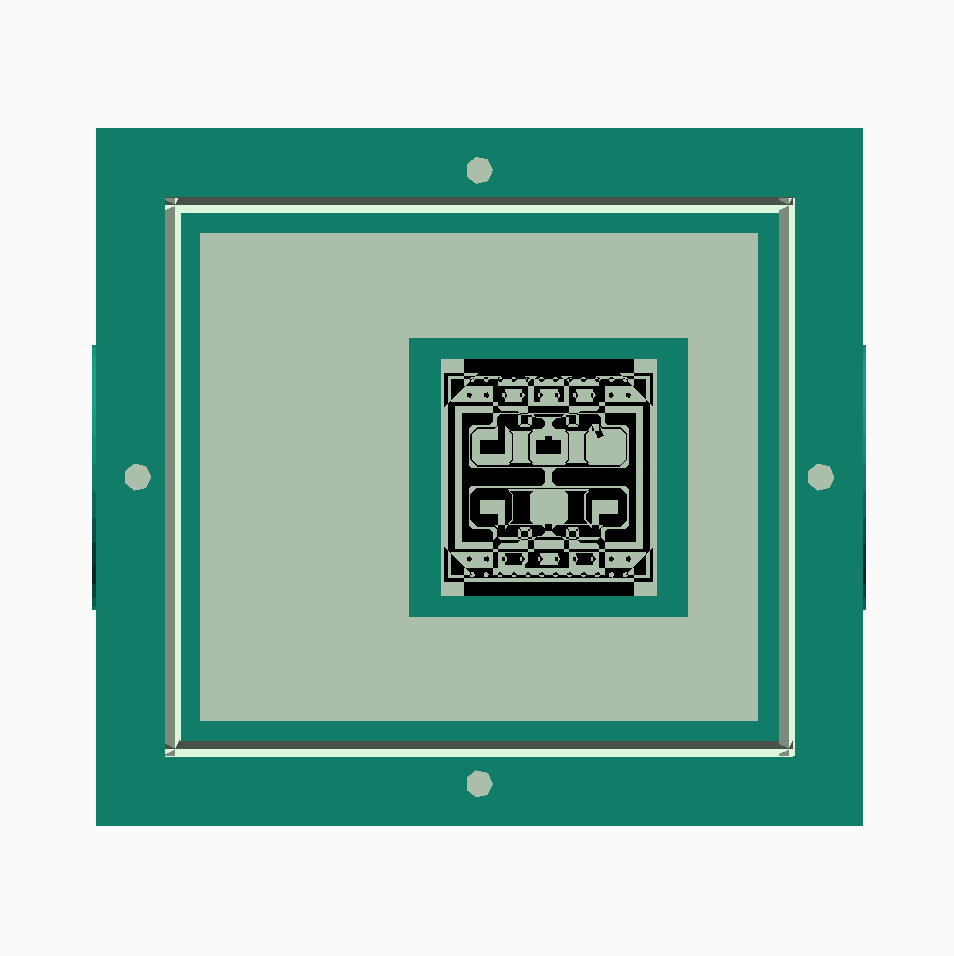
Report/Michaelmas report/Images/Plan View Openscadmodel.png
