sam-mendis/4YP/Layouts/single_cell_full_layout.dxf

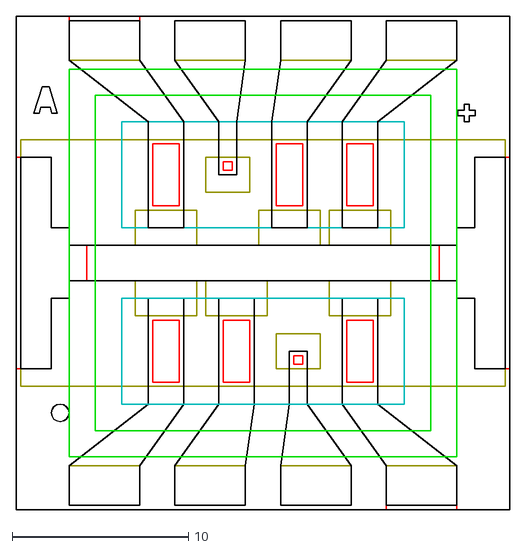
[picture p64: CAD file, 2020-11-10]
Layouts/single_cell_full_layout.dxf
28.0 x 28.0
