sam-mendis/4YP/Layouts/mask_layout.dxf

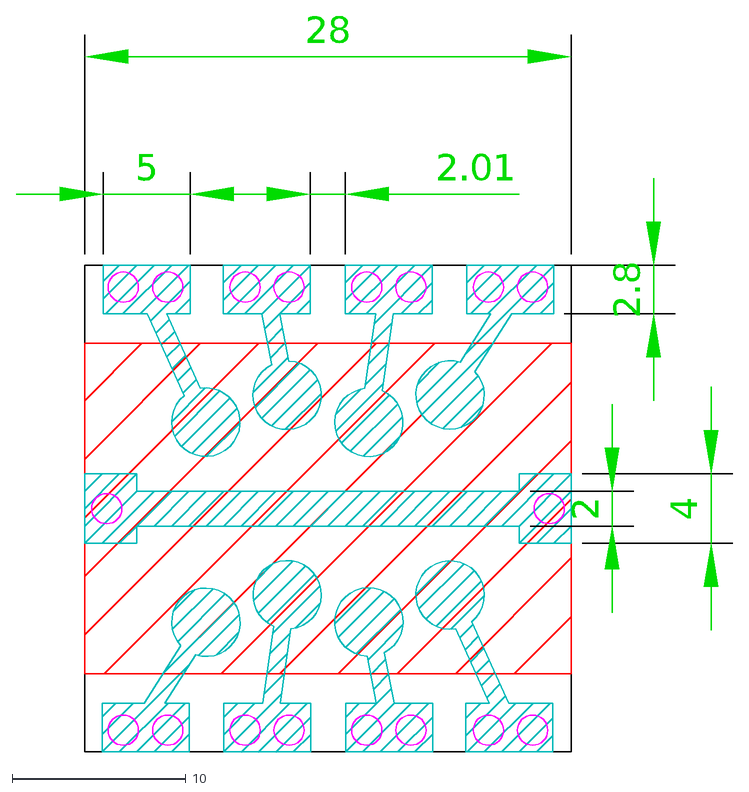
[picture p65: CAD file, 2020-11-10]
Layouts/mask_layout.dxf
28
5
2.01
4
2
2.8
