sam-mendis/4YP/Layouts/substrate-layout.dxf

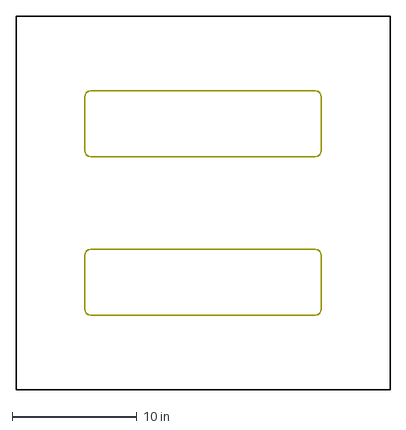
[picture p66: CAD file, 2020-11-10]
Layouts/substrate-layout.dxf
30.0 x 30.0 in
