sam-mendis/4YP/Layouts/Rebecca_EdwardsHolder.dxf

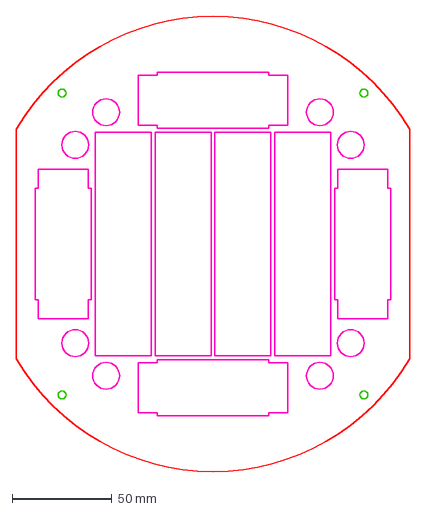
[picture p67: CAD file, 2020-11-10]
Layouts/Rebecca_EdwardsHolder.dxf
197.0 x 228.0 mm
