sam-mendis/4YP/(list of files, cad)

Other CAD files:
Random parts file/substrate-layout.dwg
substrate-layout-the-one.dwg
substrate-layout.dxf
Layouts/transistor_adapter.dxf
Layouts/layout.dxf
