sam-mendis/4YP/Report/First attempt /Images/Manufacturing_chapter/acrylic_plate.png

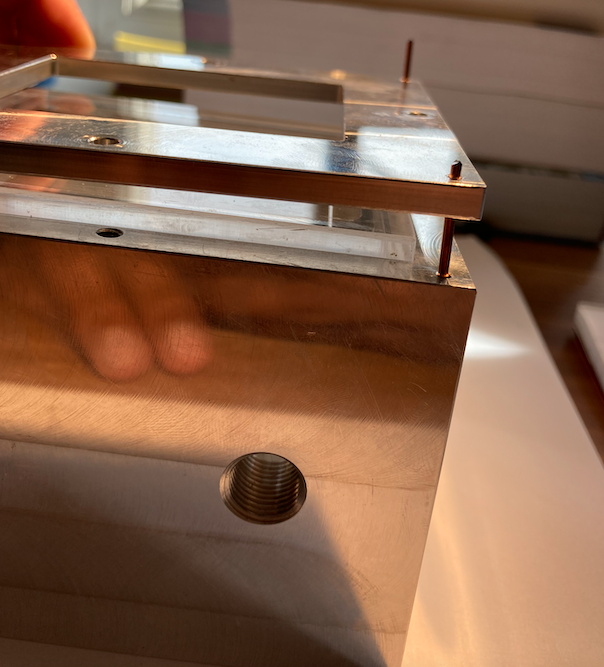
Report/First attempt /Images/Manufacturing_chapter/acrylic_plate.png
