sam-mendis/4YP/Report/First attempt /Images/Manufacturing_chapter/assembly.png

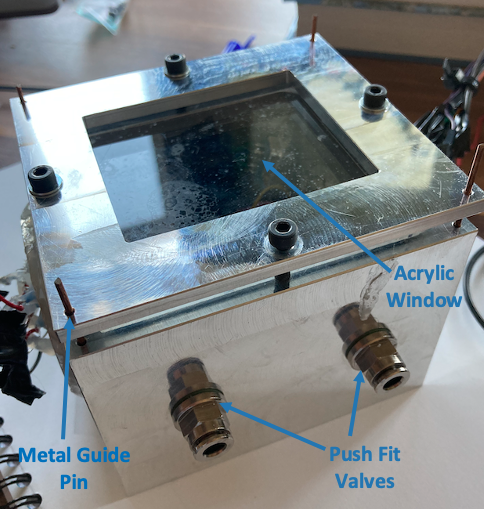
Report/First attempt /Images/Manufacturing_chapter/assembly.png
