sam-mendis/4YP/Report/First attempt /Images/Manufacturing_chapter/Base_back.jpeg

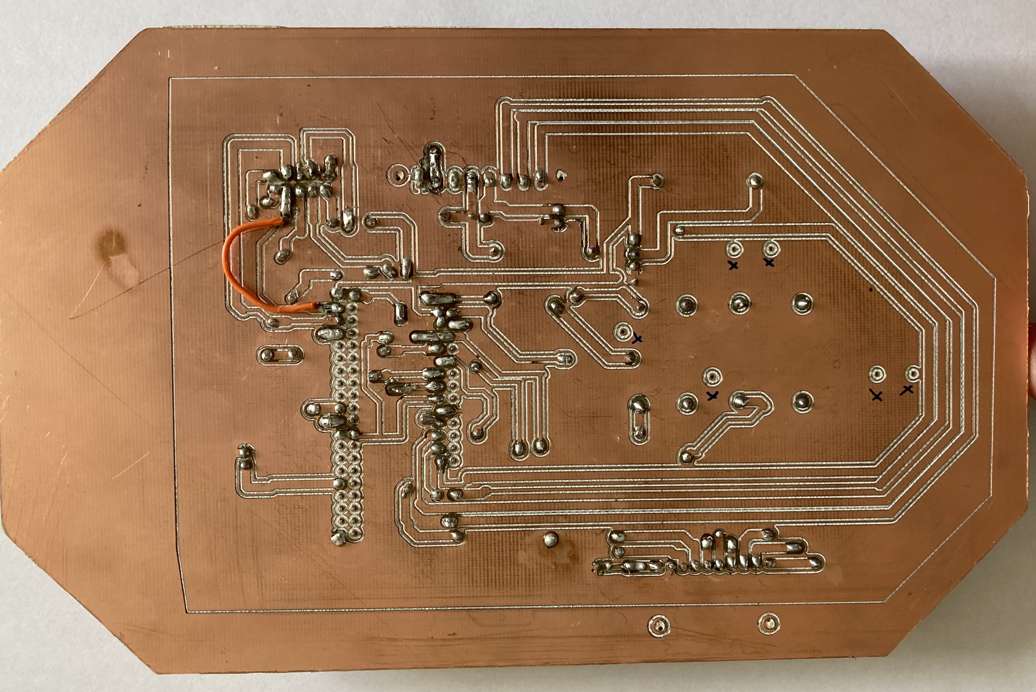
Report/First attempt /Images/Manufacturing_chapter/Base_back.jpeg
