sam-mendis/4YP/Report/First attempt /Images/Manufacturing_chapter/Base_front.png

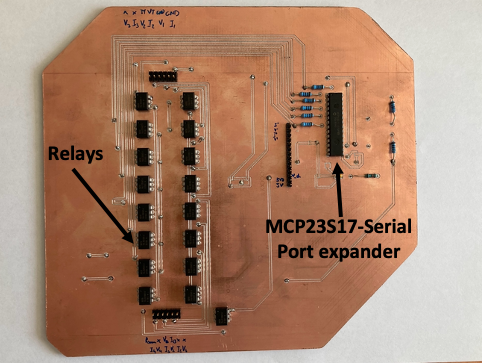
Report/First attempt /Images/Manufacturing_chapter/Base_front.png
