sam-mendis/4YP/Report/First attempt /Images/Manufacturing_chapter/code_intro.png

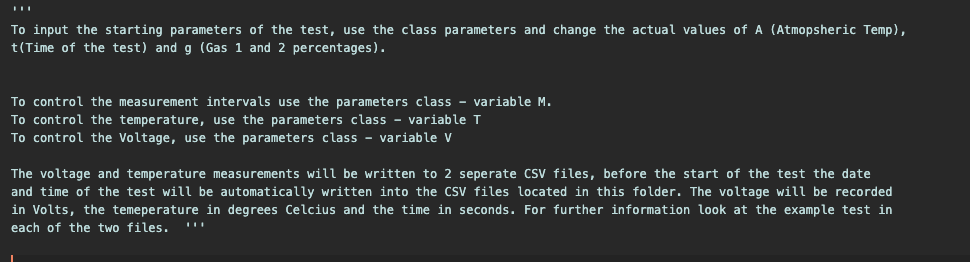
Report/First attempt /Images/Manufacturing_chapter/code_intro.png
