sam-mendis/4YP/Report/First attempt /Images/Manufacturing_chapter/elec_windows_drawings.png

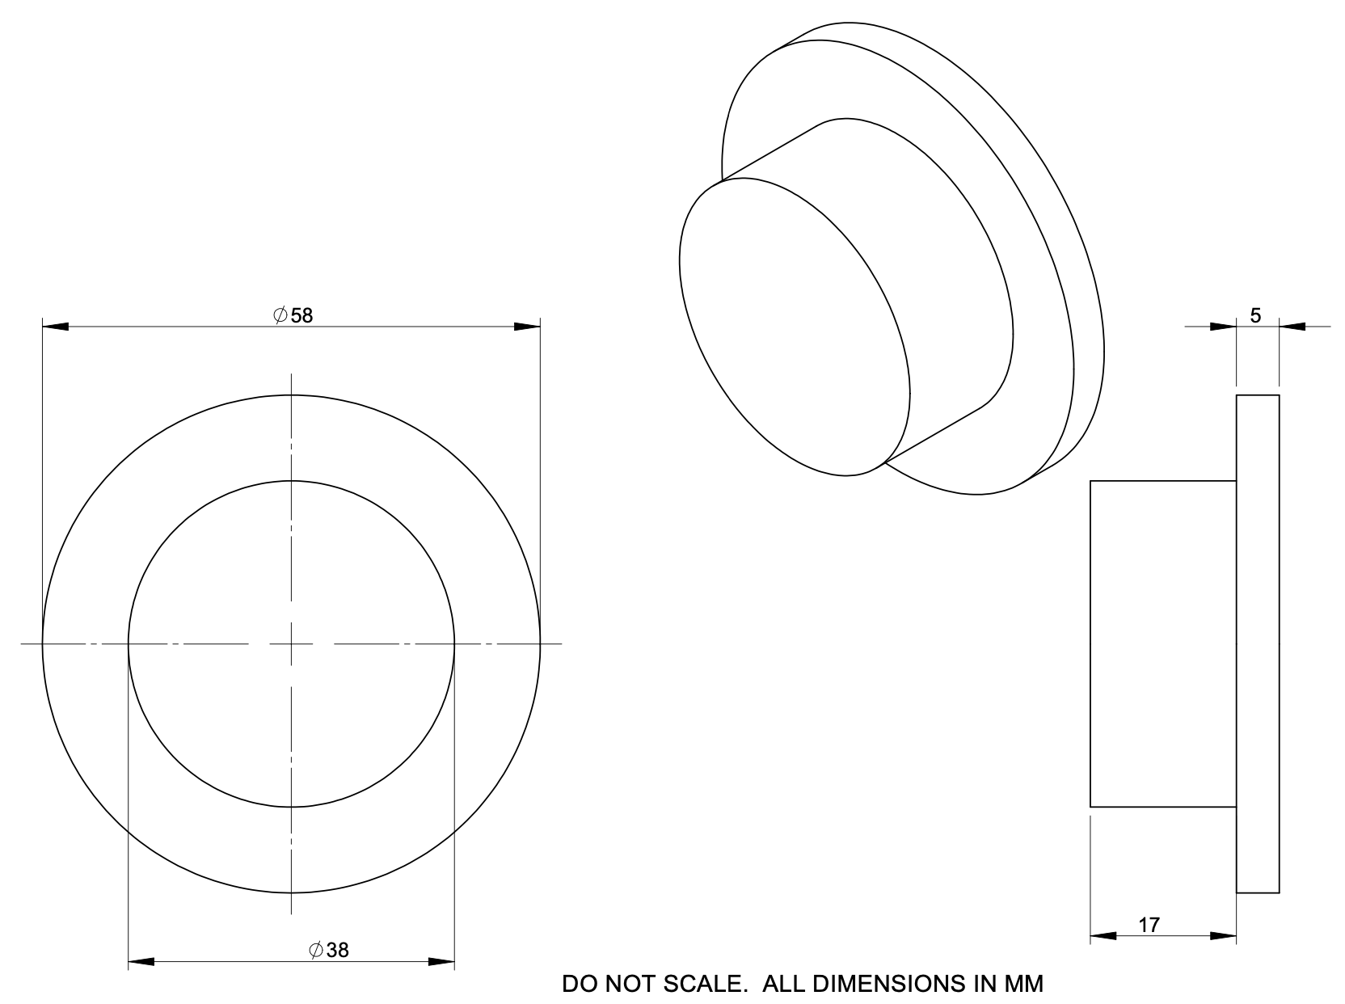
Report/First attempt /Images/Manufacturing_chapter/elec_windows_drawings.png
