sam-mendis/4YP/Report/First attempt /Images/Manufacturing_chapter/elec_windows_glued.png

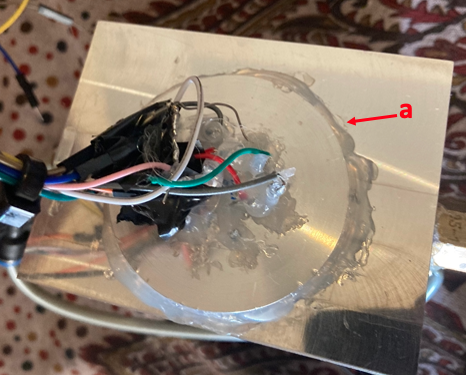
Report/First attempt /Images/Manufacturing_chapter/elec_windows_glued.png
