sam-mendis/4YP/Report/First attempt /Images/Manufacturing_chapter/Faliure1.jpeg

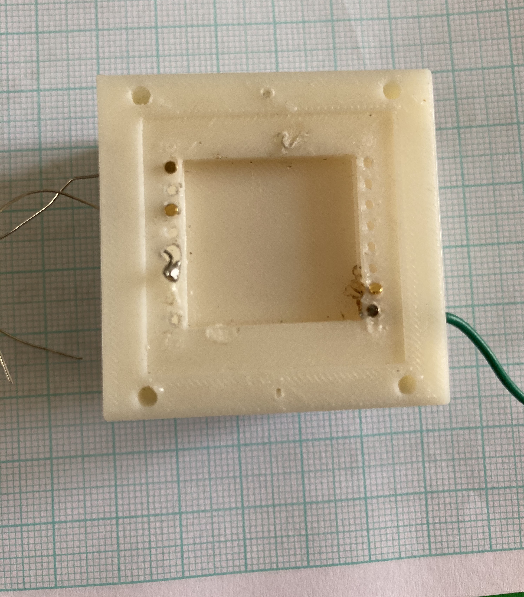
Report/First attempt /Images/Manufacturing_chapter/Faliure1.jpeg
