sam-mendis/4YP/Report/First attempt /Images/Manufacturing_chapter/Faliure2.jpeg

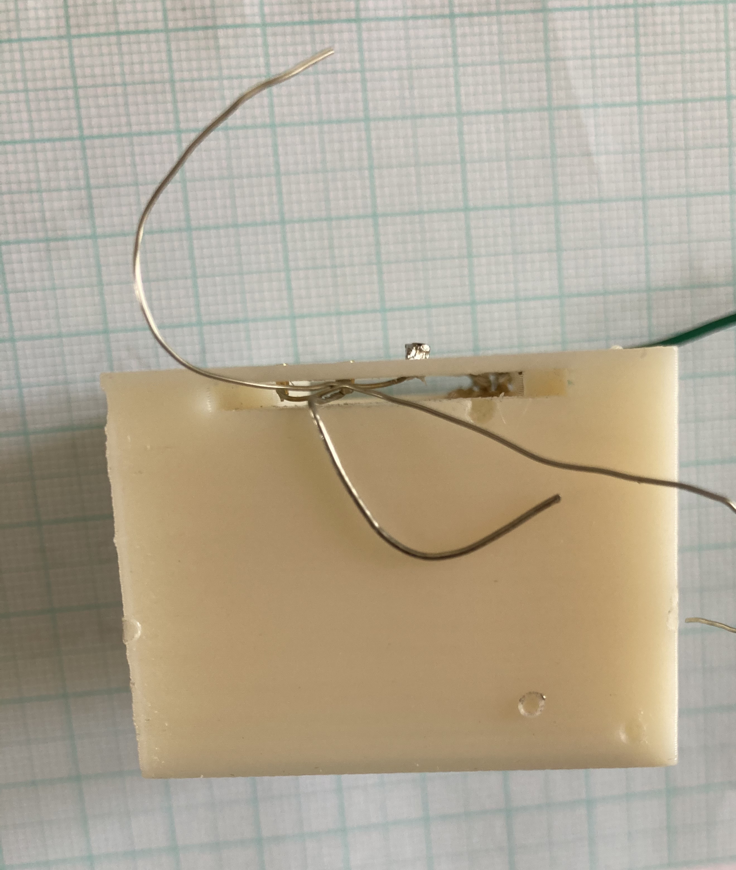
Report/First attempt /Images/Manufacturing_chapter/Faliure2.jpeg
