sam-mendis/4YP/Report/First attempt /Images/Manufacturing_chapter/final.png

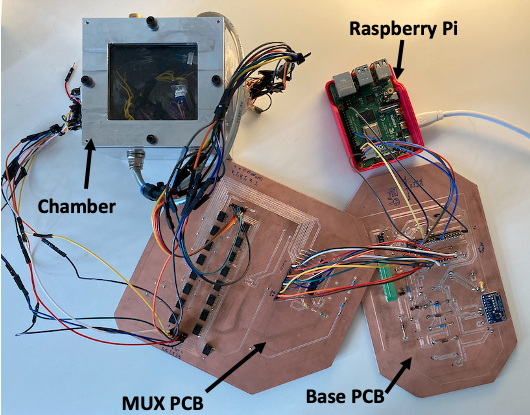
Report/First attempt /Images/Manufacturing_chapter/final.png
