sam-mendis/4YP/Report/First attempt /Images/Manufacturing_chapter/lid_HT.png

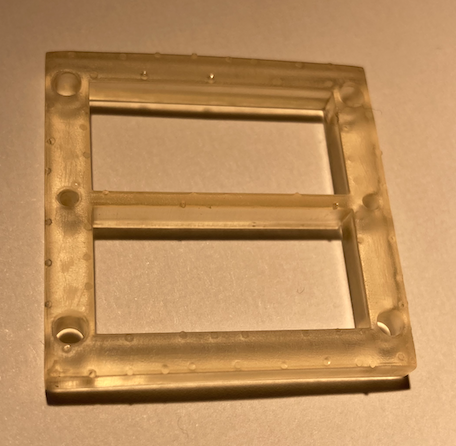
Report/First attempt /Images/Manufacturing_chapter/lid_HT.png
