sam-mendis/4YP/Report/First attempt /Images/Manufacturing_chapter/Mux_back.jpeg

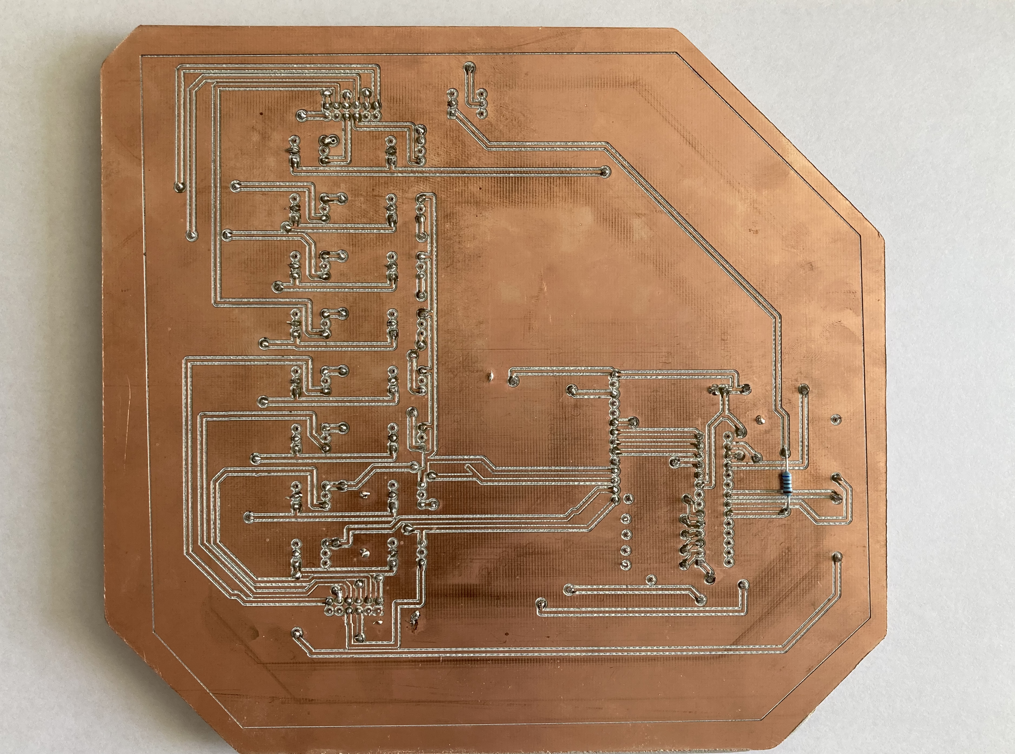
Report/First attempt /Images/Manufacturing_chapter/Mux_back.jpeg
