sam-mendis/4YP/Report/First attempt /Images/Manufacturing_chapter/Mux_front.png

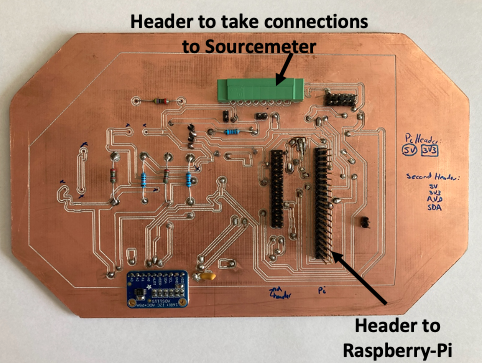
Report/First attempt /Images/Manufacturing_chapter/Mux_front.png
