sam-mendis/4YP/Report/First attempt /Images/Manufacturing_chapter/oring_assem.png

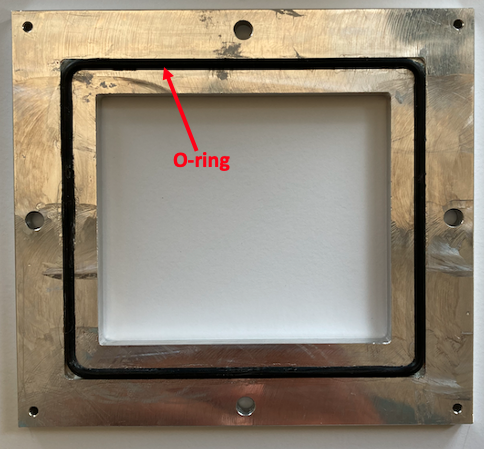
Report/First attempt /Images/Manufacturing_chapter/oring_assem.png
