sam-mendis/4YP/Report/First attempt /Images/Manufacturing_chapter/safety_relief.png

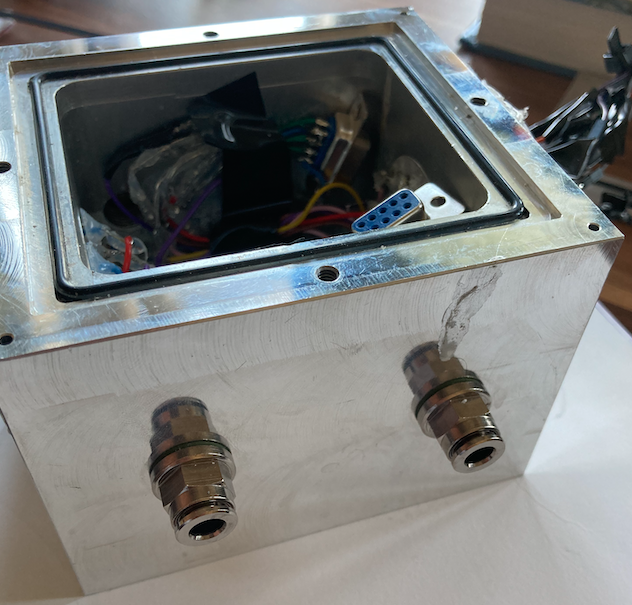
Report/First attempt /Images/Manufacturing_chapter/safety_relief.png
