sam-mendis/4YP/Report/First attempt /Images/Manufacturing_chapter/substrate_fail.png

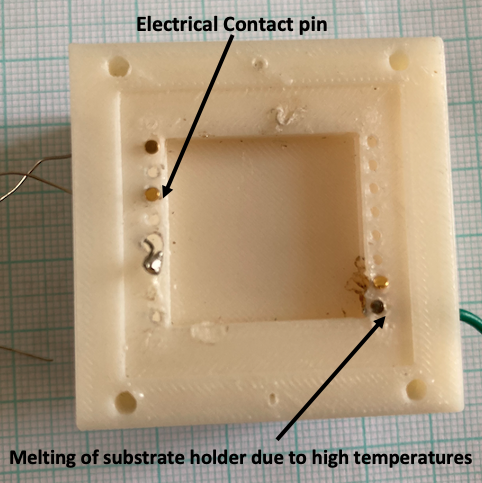
Report/First attempt /Images/Manufacturing_chapter/substrate_fail.png
