sam-mendis/4YP/Report/First attempt /Images/Testing_chapter/calc_test_assembly.png

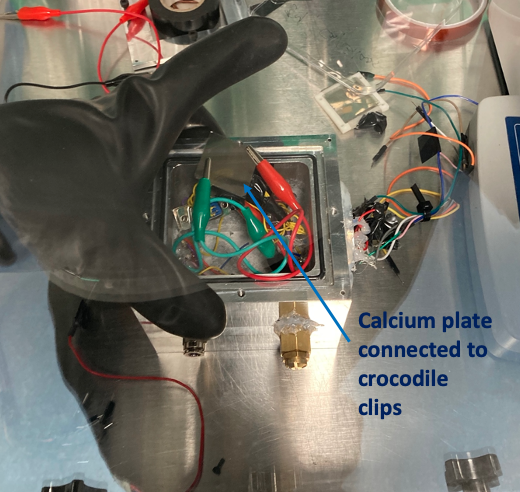
Report/First attempt /Images/Testing_chapter/calc_test_assembly.png
