sam-mendis/4YP/Report/First attempt /Images/Testing_chapter/bubbles1.png

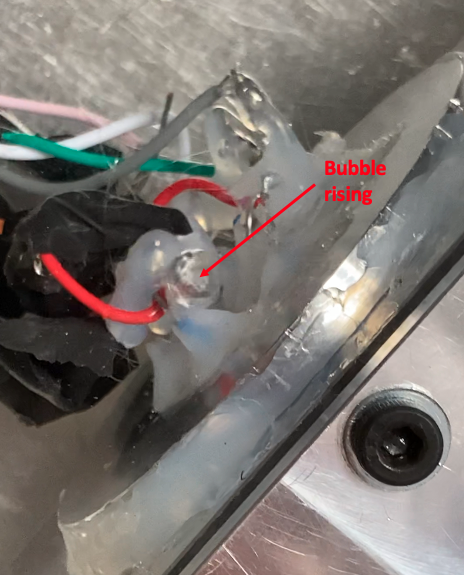
Report/First attempt /Images/Testing_chapter/bubbles1.png
