sam-mendis/4YP/Report/First attempt /Images/Testing_chapter/bubbles2.png

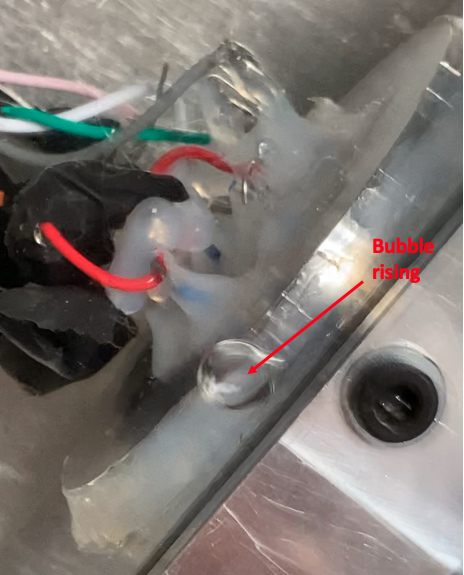
Report/First attempt /Images/Testing_chapter/bubbles2.png
