sam-mendis/4YP/Report/First attempt /Images/Testing_chapter/calc_test1.png

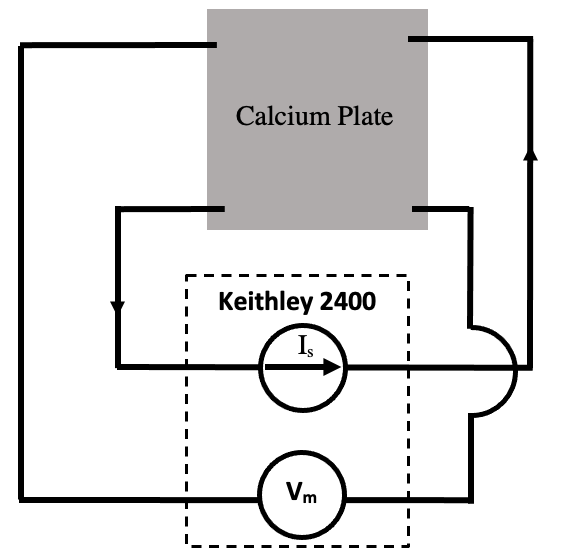
Report/First attempt /Images/Testing_chapter/calc_test1.png
