sam-mendis/4YP/Report/First attempt /Images/Testing_chapter/D_sub.png

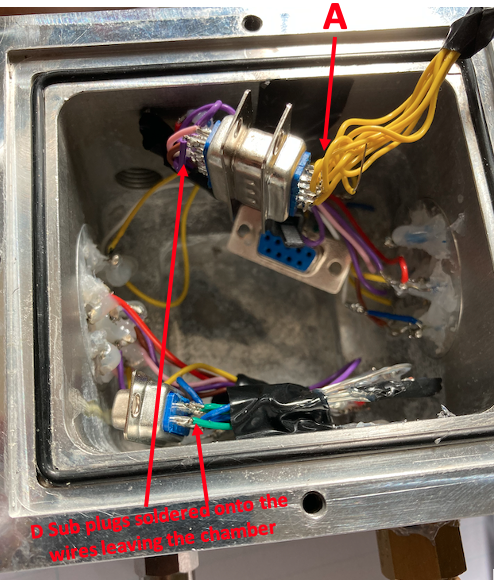
Report/First attempt /Images/Testing_chapter/D_sub.png
