sam-mendis/4YP/Report/First attempt /Images/Testing_chapter/glovebox_c_test.png

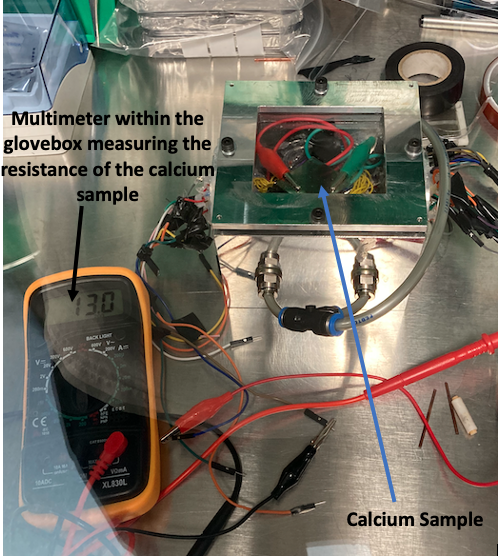
Report/First attempt /Images/Testing_chapter/glovebox_c_test.png
