sam-mendis/4YP/Report/First attempt /Images/Testing_chapter/heat_sim_2.png

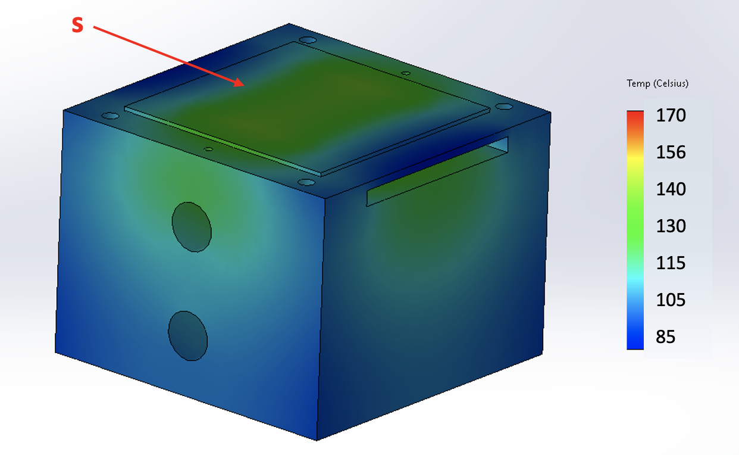
Report/First attempt /Images/Testing_chapter/heat_sim_2.png
