sam-mendis/4YP/Report/First attempt /Images/Testing_chapter/jumpers.png

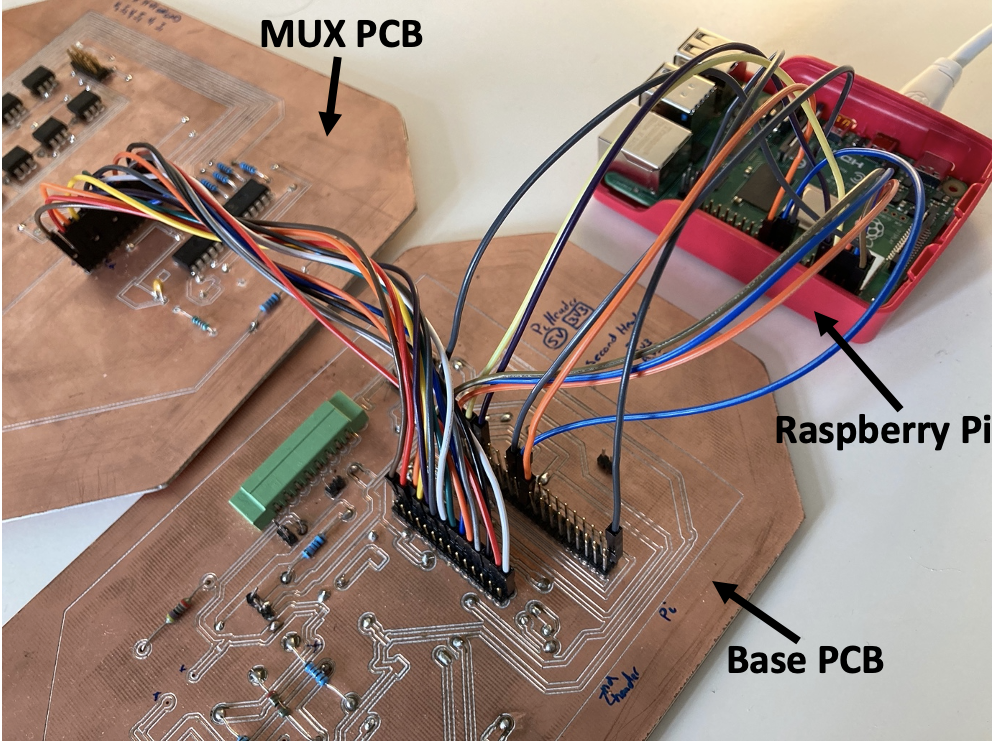
Report/First attempt /Images/Testing_chapter/jumpers.png
