sam-mendis/4YP/Report/First attempt /Images/Testing_chapter/overlay.jpeg

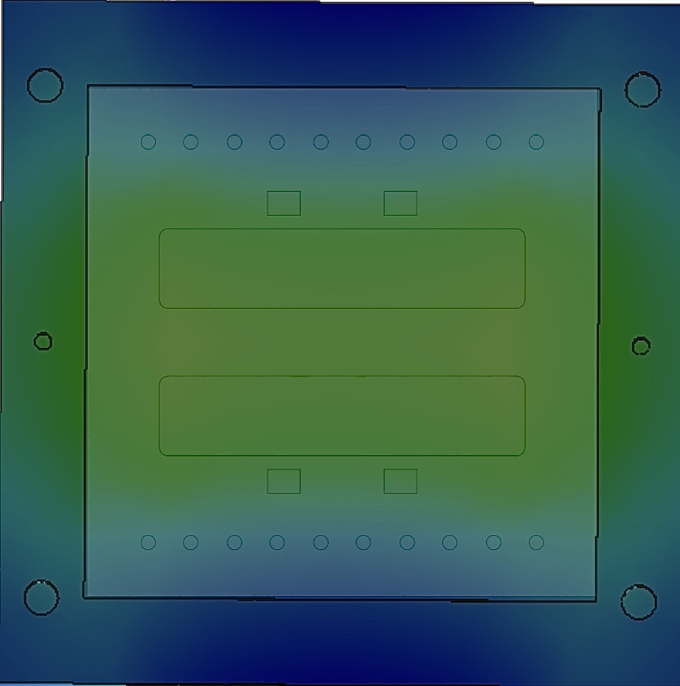
Report/First attempt /Images/Testing_chapter/overlay.jpeg
