sam-mendis/4YP/Report/First attempt /Images/Testing_chapter/sc_1.png

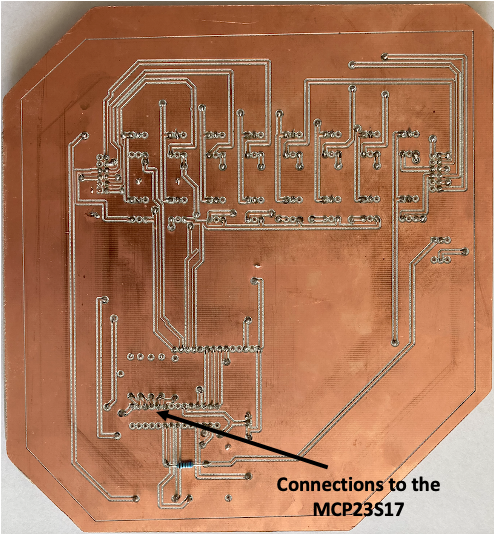
Report/First attempt /Images/Testing_chapter/sc_1.png
