sam-mendis/4YP/Report/First attempt /Images/Testing_chapter/sc_2.png

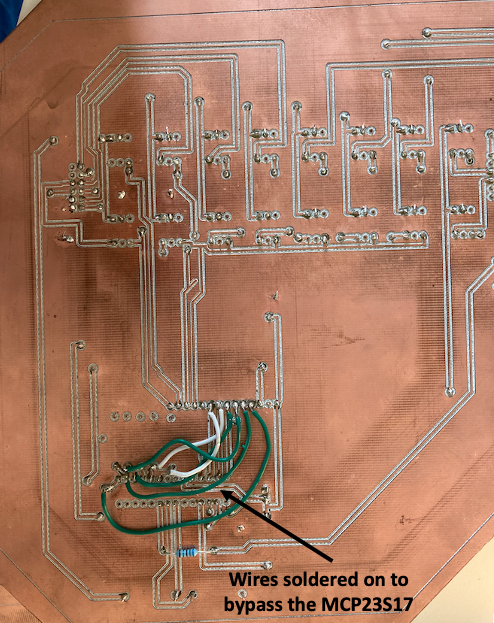
Report/First attempt /Images/Testing_chapter/sc_2.png
