sam-mendis/4YP/Report/First attempt /Images/Conclusion/computer_risk_assessment.png

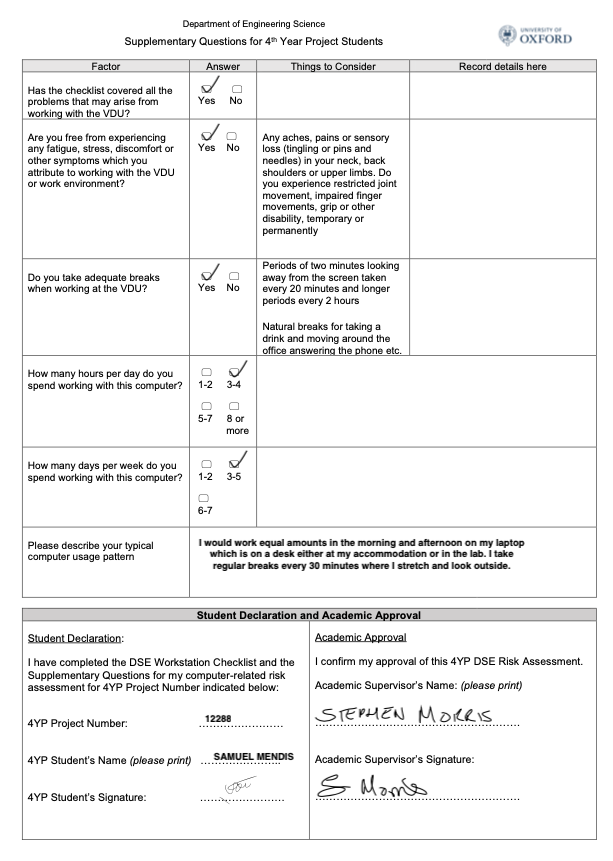
Report/First attempt /Images/Conclusion/computer_risk_assessment.png
