sam-mendis/4YP/Report/First attempt /Images/Conclusion/p1_risk_assessment.png

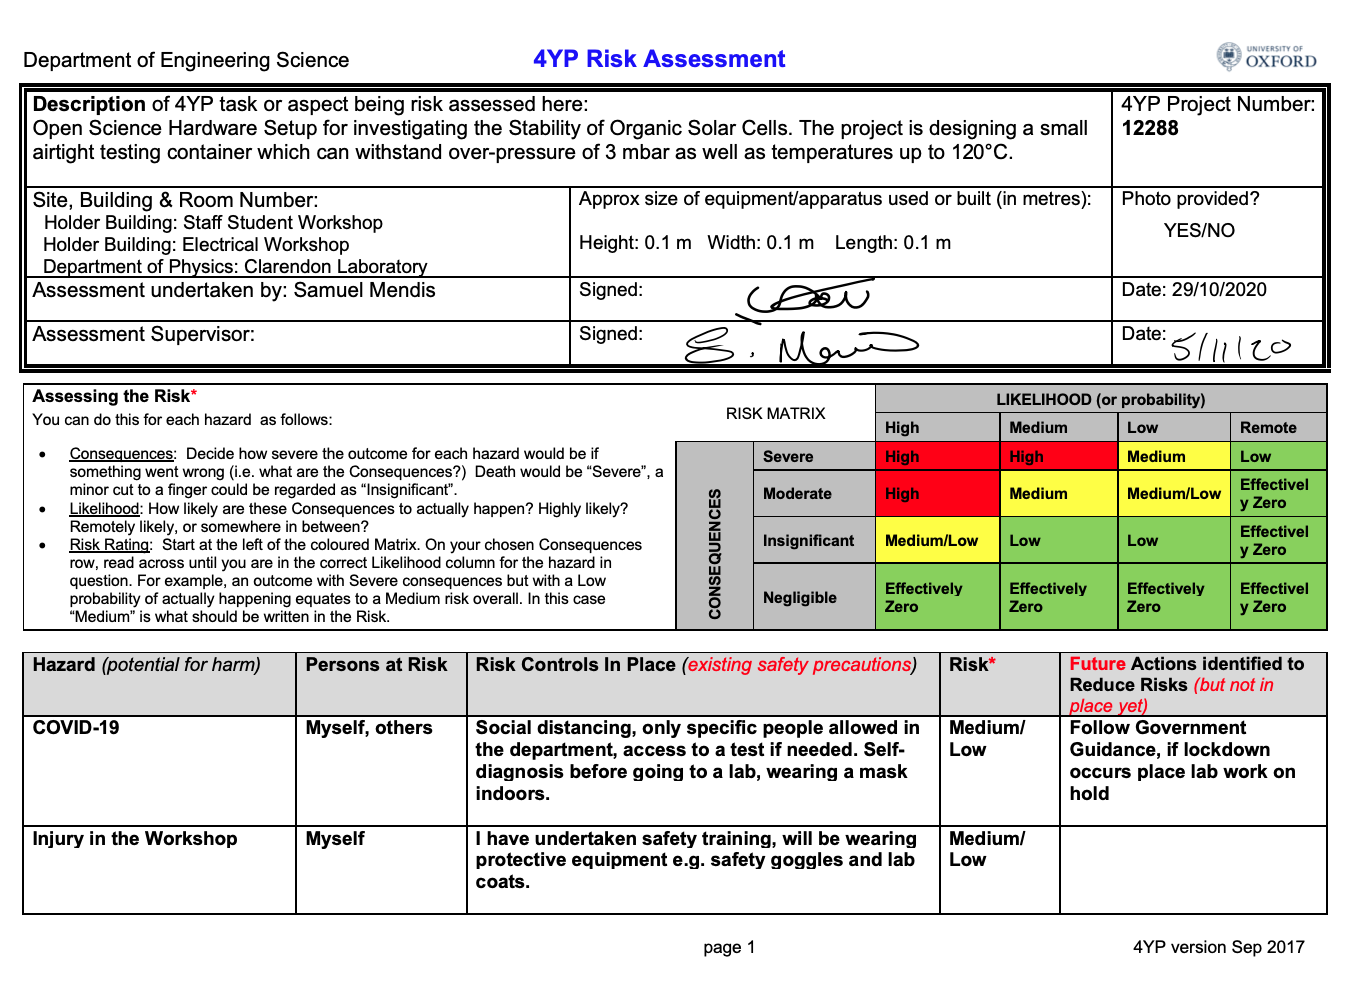
Report/First attempt /Images/Conclusion/p1_risk_assessment.png
