sam-mendis/4YP/Report/First attempt /Images/Greys Base8x schematic.pdf

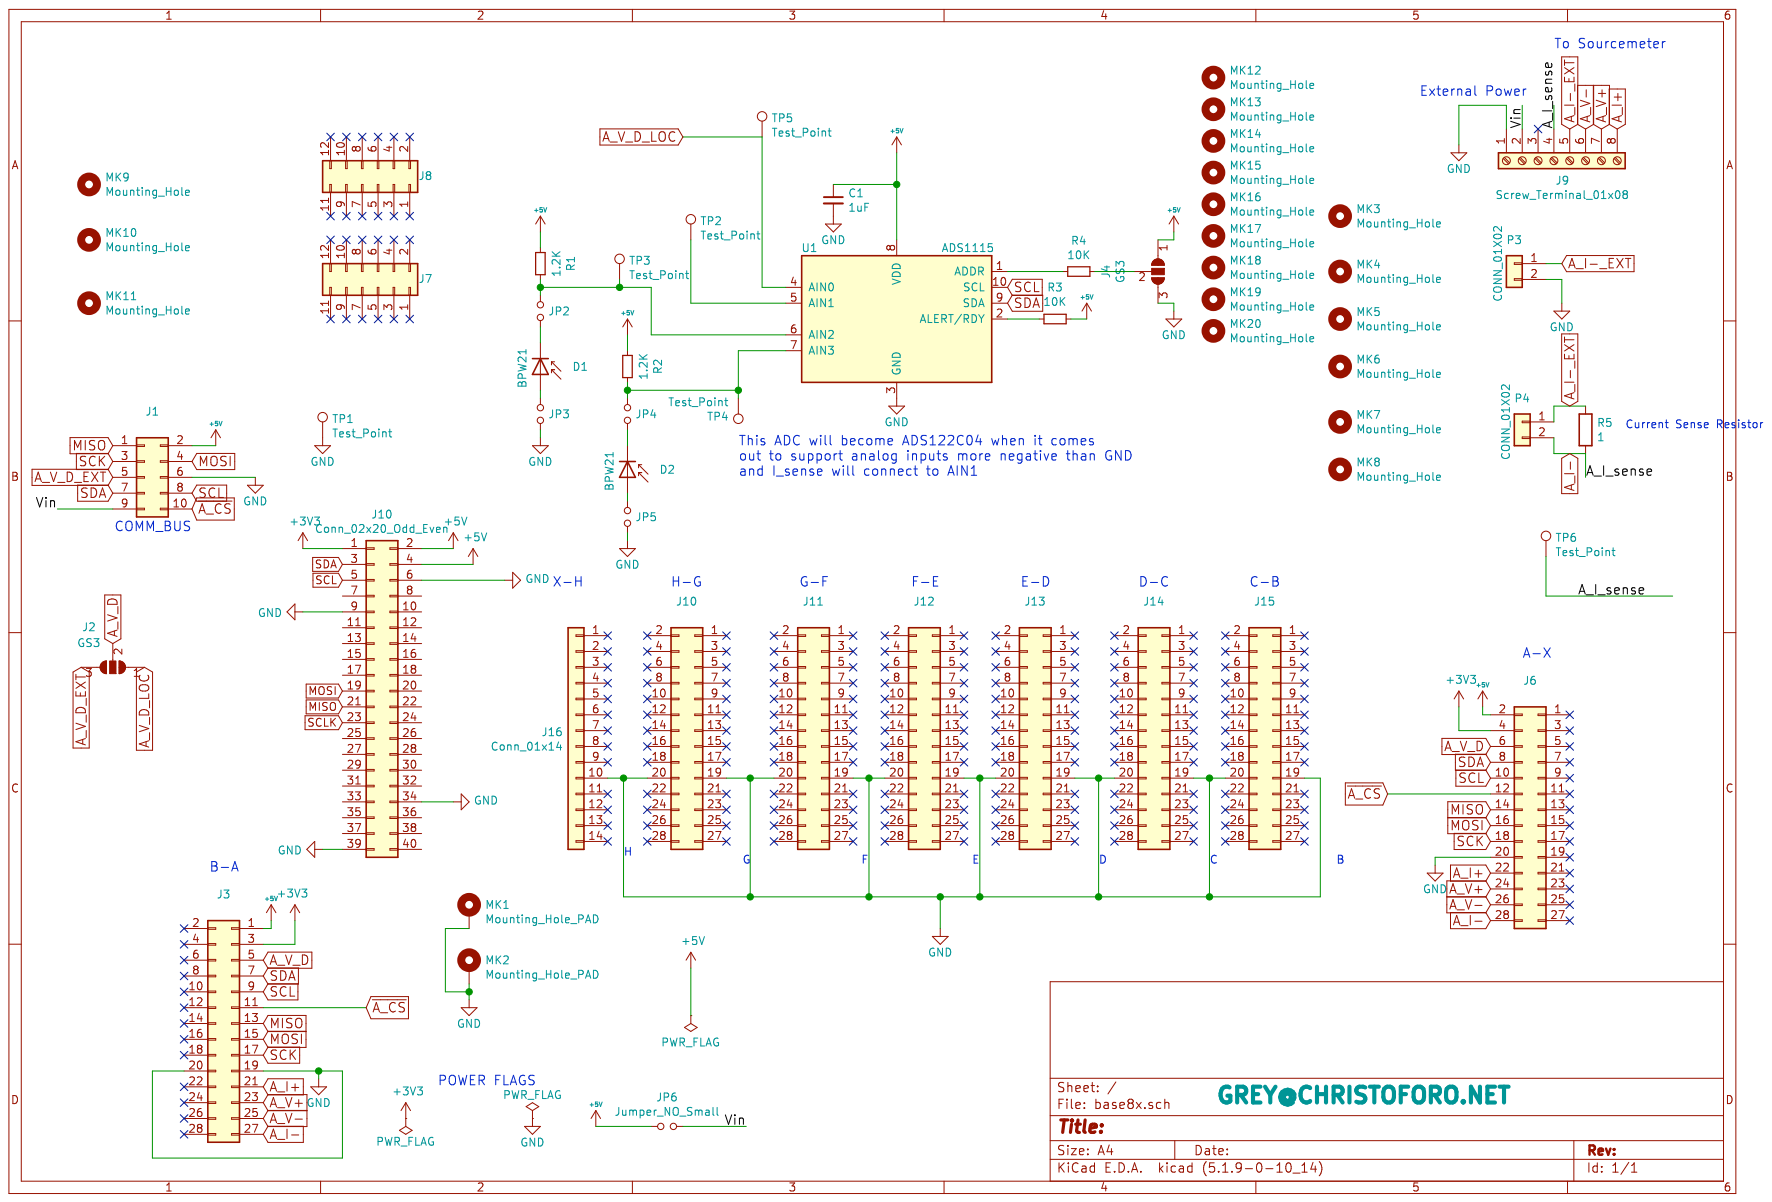
[picture p103: page 1]
