sam-mendis/4YP/Report/First attempt /Images/Greys solar mux schematic.pdf

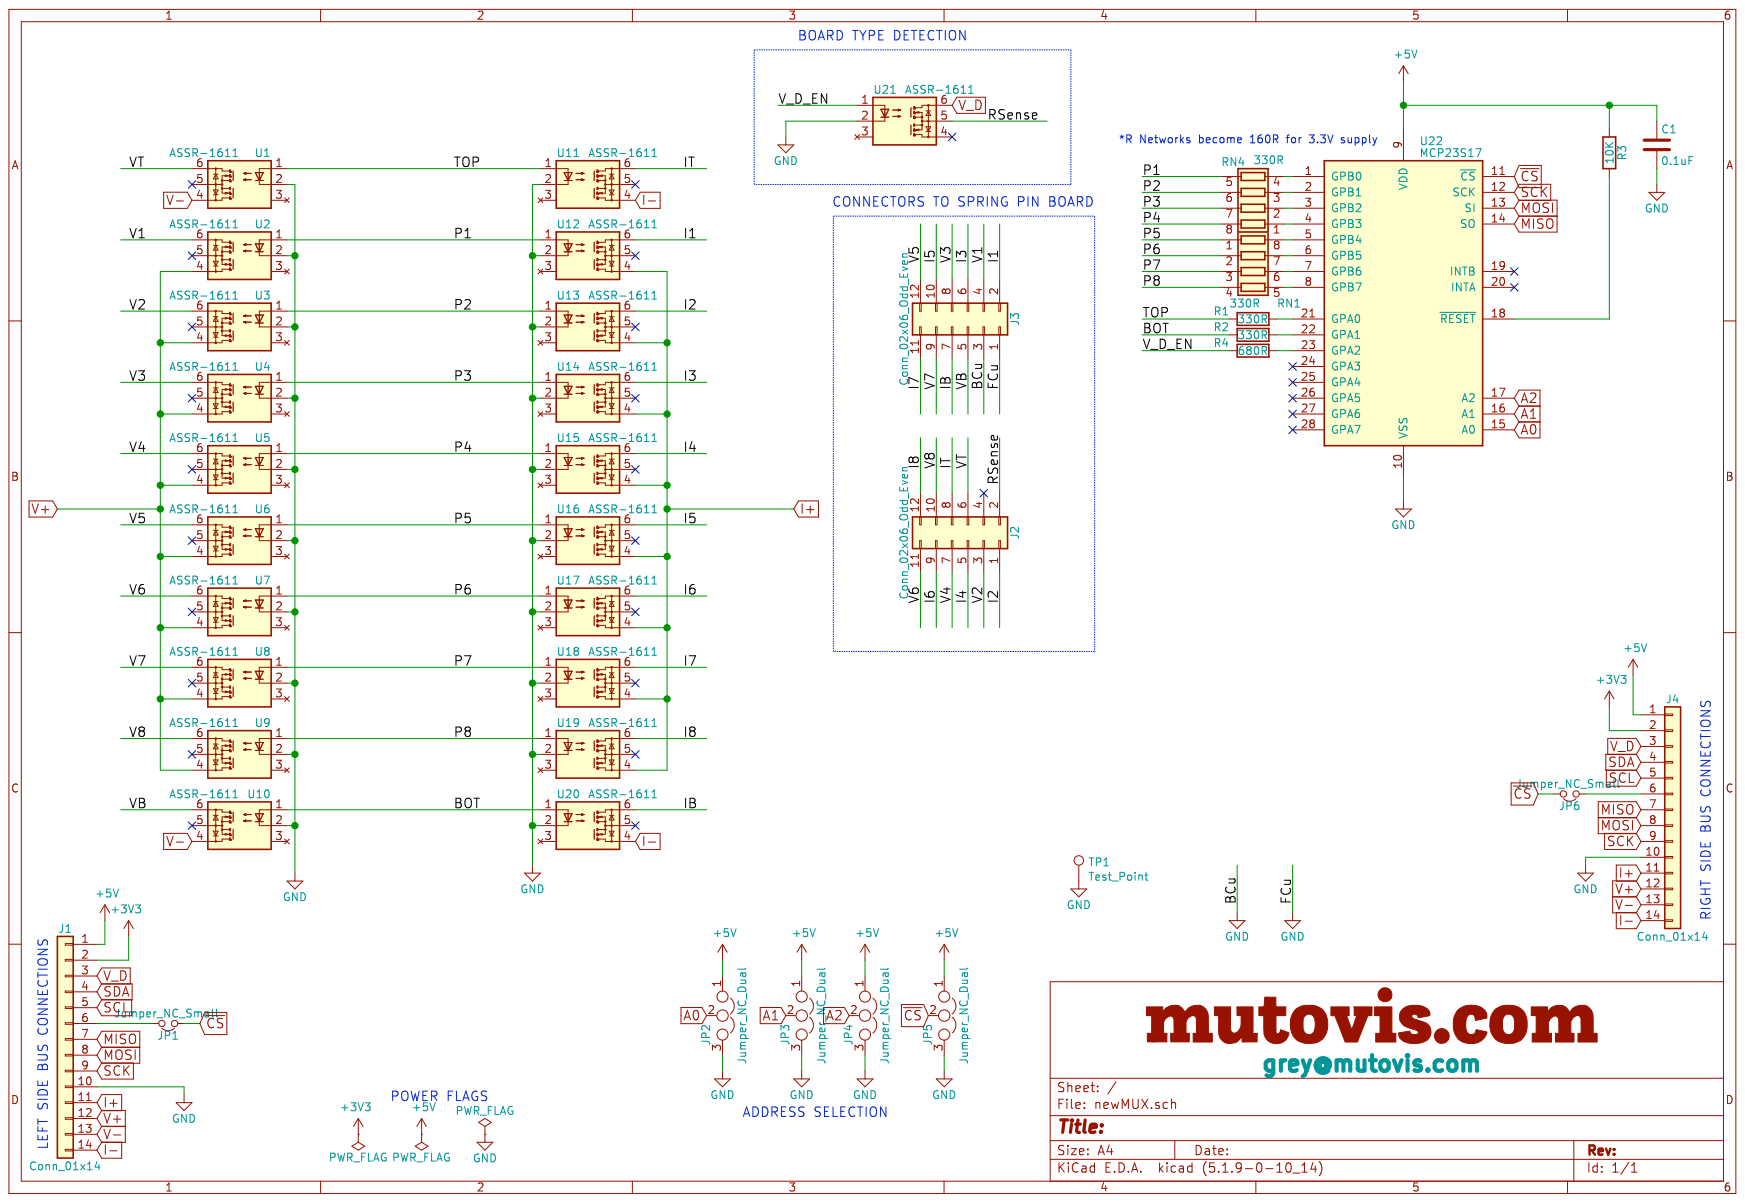
[picture p104: page 1]
