sam-mendis/4YP/(commit log)

2020-09-02 Create first iteration attempt.scad
    [first iteration attempt.scad]
2020-09-04 Update first iteration attempt.scad
    [first iteration attempt.scad]
2020-11-03 Second 3d print files
    [cell_contacts.stl, elec_contacts.stl, outer_shell.stl, quartz_window.stl]
2020-11-05 report edits
    [Substrate_holder.scad, cell_contacts.scad, elec_contacts.scad, first iteration attempt.scad, outer_shell.scad, substratelayout.scad]
2020-11-10 difficult parts
    [Rebecca_EdwardsHolder.dxf, Substrate_holder.scad, Substrate_holder.stl, Untitled.scad, layout.dxf, mask_layout.dxf, outer_shell.scad, outer_shell.stl]
2020-11-17 report changes
    [Untitled.scad, first iteration attempt.scad, lid profile.scad, metal_lid.scad, outer_shell.scad, quartz_window.scad]
2020-11-18 Update lid profile.scad
    [lid profile.scad]
2021-02-24 Clean Up
    [Substrate Holder final.step, Substrate_holder.scad, Substrate_holder.stl, Substrate_holder_SamMendis.stl, Untitled.scad, bracket.scad, cartridge_heater.scad, cartridge_heater.step]
